drewsum/AC_Power_Meter/README.md

# AC_Power_Meter
ELEN3035 Final Project

AC Power Meter centered around an 8 bit PIC microcontroller

Built with KiCad 5.0.1 (with custom library), MPLAB X 5.05, and XC8 C compiler 1.45
