drewsum/AC_Power_Meter/hdw/AC_Power_Meter/AC_Power_Meter_bom.xlsx

References | Value | Quantity Per PCB | Digi-Key PN | Footprint | Dielectric | Voltage | Tolerance | Ampacity | Wattage | Config
C301 C504 C604 C607 C701 C704 C708 C803 C807 C808 C901 C902 C911 C917 C1004 C1005 C1006 C1009 C1012 C1013 C1014 C1101 C1103 C1201 C1403 C1405 C1501 | 0.1uF | 27 | 490-8020-1-ND | 0603 | X7R | 50V
C605 | 0.47uF | 1 | 490-3291-1-ND | 0603 | X7R | 25V
C302 C702 C705 C709 C804 C903 C904 C912 C918 C1202 C1404 | 10nF | 11 | 1276-1921-1-ND | 0603 | X7R | 50V
C1502 | 10nF | 1 | 445-2291-1-ND | 1206 | X7R | 630V
C608 C609 C907 C908 C914 C916 C920 | 10uF | 7 | 490-10517-1-ND | 0805 | X7R | 6.3V
C606 | 15pF | 1 | 478-10290-1-ND | 0603 | C0G/NP0 | 50V
C303 C703 C706 C710 C805 C905 C906 C913 C919 C1203 C1406 | 1nF | 11 | 478-1215-1-ND | 0603 | X7R | 50V
C909 C910 C915 C921 C1204 | 1uF | 5 | 490-1695-1-ND | 0805 | X7R | 10V
C1401 | 4.7nF | 1 | 399-9245-1-ND | 0805 | X7R | 200V
C601 C603 C1008 | 4.7uF | 3 | 478-10056-1-ND | 0805 | X7R | 25V
C1010 C1011 | 47pF | 2 | 478-1171-1-ND | 0603 | C0G/NP0 | 50V
C505 | 47uF | 1 | 478-3938-1-ND | 7343 |  | 16V | 10%
D901 | 1N4148WS | 1 | 1N4148WSFSCT-ND
D1401 D1402 D1403 D1404 D1405 | BAV21 | 5 | BAV21W-FDICT-ND
D1602 D1604 | Green | 2 | 160-1446-1-ND | 0603
D1601 D1605 | Red | 2 | 160-1447-1-ND | 0603
D1002 | Yellow | 1 | 160-1448-1-ND | 0603
F201 F401 | 15A | 2 | 283-4372-1-ND
F501 F502 | 3.15A | 2 | 283-4107-1-ND
HS1501 | Heatsink | 1
J501 | AUX_IN | 1
J203 | EARTH_IN | 1 | 36-8191-ND
J403 | EARTH_OUT | 1 | 36-8191-ND
J201 | HT_IN | 1 | 36-8191-ND
J401 | HT_OUT | 1 | 36-8191-ND
J202 | NEUT_IN | 1 | 36-8191-ND
J402 | NEUT_OUT | 1 | 36-8191-ND
J404 | Output Socket | 1 | Q337-ND
J801 | Prog | 1
J1001 | USB_B_Mini | 1 | 732-2109-1-ND
L601 | 3.3u | 1 | 541-2567-1-ND | IHLP1212 |  |  | 20% | 2.7A
L801 L802 L1001 L1002 | 600R 0.5A | 4 | 732-1593-1-ND
MK201 MK203 MK1303 MK1304 MK1307 MK1311 MK1312 MK1315 MK1316 | 4-40 Screw | 9 | 36-9502-ND 36-9900-ND
MK1305 MK1306 MK1309 MK1313 MK1314 MK1317 MK1318 | 4-40 Standoff | 7 | 36-8400-ND
MK1301 | Housing | 1
MK1302 | Lid | 1
MK202 MK204 | Nut | 2 | 36-4694-ND
P201 | AC In Socket | 1 | Q223-ND
PS501 | TMLM04112 | 1 | 1951-1352-ND
Q1401 Q1402 Q1403 Q1404 | 2N7002 | 4
Q1501 | BT139-600 | 1 | 1740-1050-ND
Q501 | DMP3099L-7 | 1 | DMP3099L-7DICT-ND
R701 R702 R1201 R1202 | 0 | 4 | P0.0GCT-ND | 0603 |  |  | 1% |  | 1/10W
R302 R806 | 0 | 0 |  | 0603 |  |  | 1% |  | 1/10W | None
R1405 R1406 R1407 R1408 | 10 | 4 | MCT0603-10.0-CFCT-ND | 0603 |  |  | 1% |  | 2018-01-10
R1401 | 100k | 1 | RHM100KICT-ND | 1206 |  |  | 5% |  | 1/2W
R1403 | 100k | 1 | P100KHCT-ND | 0603 |  |  | 1% |  | 1/10W
R301 R501 R508 R602 R603 R606 R703 R704 R705 R805 R901 R902 R904 R905 R906 R909 R910 R1004 R1101 R1102 R1103 R1104 R1203 R1204 R1404 R1501 R1502 R1601 R1602 R1606 R1609 | 10k | 31 | RHM10KADCT-ND | 0603 |  |  | 1% |  | 1/10W
R1505 | 180 | 1 | A115990CT-ND | 2512 |  |  | 1% |  | 1W
R608 R907 | 1M | 2 | A130109CT-ND | 0603 |  |  | 1% |  | 1/10W
R807 R908 R1009 R1402 R1603 R1604 R1608 R1611 | 1k | 8 | MCT0603-1.00K-CFCT-ND | 0603 |  |  | 1% |  | 1/10W
R1504 | 1k | 1 | 541-1.0KXCT-ND | 2512 |  |  | 5% |  | 1W
R1503 | 220 | 1 | 311-220HRCT-ND | 0603 |  |  | 1% |  | 1/10W
R1007 R1008 | 27 | 2 | P27.0HCT-ND | 0603 |  |  | 1% |  | 1/10W
R502 R903 | 3.3k | 2 | 311-3.30KHRCT-ND | 0603 |  |  | 1% |  | 1/10W
R1506 | 39 | 1 | 541-39XCT-ND | 2512 |  |  | 5% |  | 1W
R607 | 43.2k | 1 | P43.2KHCT-ND | 0603 |  |  | 1% |  | 1/10W
R609 | 576k | 1 | 311-576KHRCT-ND | 0603 |  |  | 1% |  | 1/10W
R605 | 80.6k | 1 | P80.6KHCT-ND | 0603 |  |  | 1% |  | 1/10W
SW801 | MRESET | 1
U1402 | 74LVC1G17 | 1 | 296-11934-1-ND
U1501 | 74LVC1G32 | 1 | 296-9848-1-ND
U301 | ACS722LLCTR-20AB | 1 | 620-1637-1-ND
U1502 | FOD4218 | 1 | FOD4218S-ND
U1002 | FT234XD | 1 | 768-1178-1-ND
U1101 | ISO7321C | 1 | 296-42102-1-ND
U602 | LT3973-DD | 1 | LT3973EDD#PBF-ND
U901 U902 U903 U904 | LTC6240IS5 | 4 | LTC6240IS5#TRMPBFCT-ND
U1401 | LTV-356T | 1 | 160-1337-1-ND
U701 | PIC18LF67K40-I/PT | 1 | PIC18LF67K40-I/PT-ND
U1201 | SSD1306 | 1
U1004 | TPD3S014DBVR | 1 | 296-38835-1-ND
X701 | ASV-16.000MHz | 1 | 535-10072-1-ND
Z501 | UDZSTE-175.1B | 1 | UDZSTE-175.1BCT-ND | SOD323 |  | 5.1V
