drewsum/AC_Power_Meter/(list of files, cad)

Other CAD files:
sfw/U701_Firmware/AC_Power_Meter.X/dist/default/production/AC_Power_Meter.X.production.obj
