drewsum/AC_Power_Meter/hdw/AC_Power_Meter/AC_Power_Meter.pdf

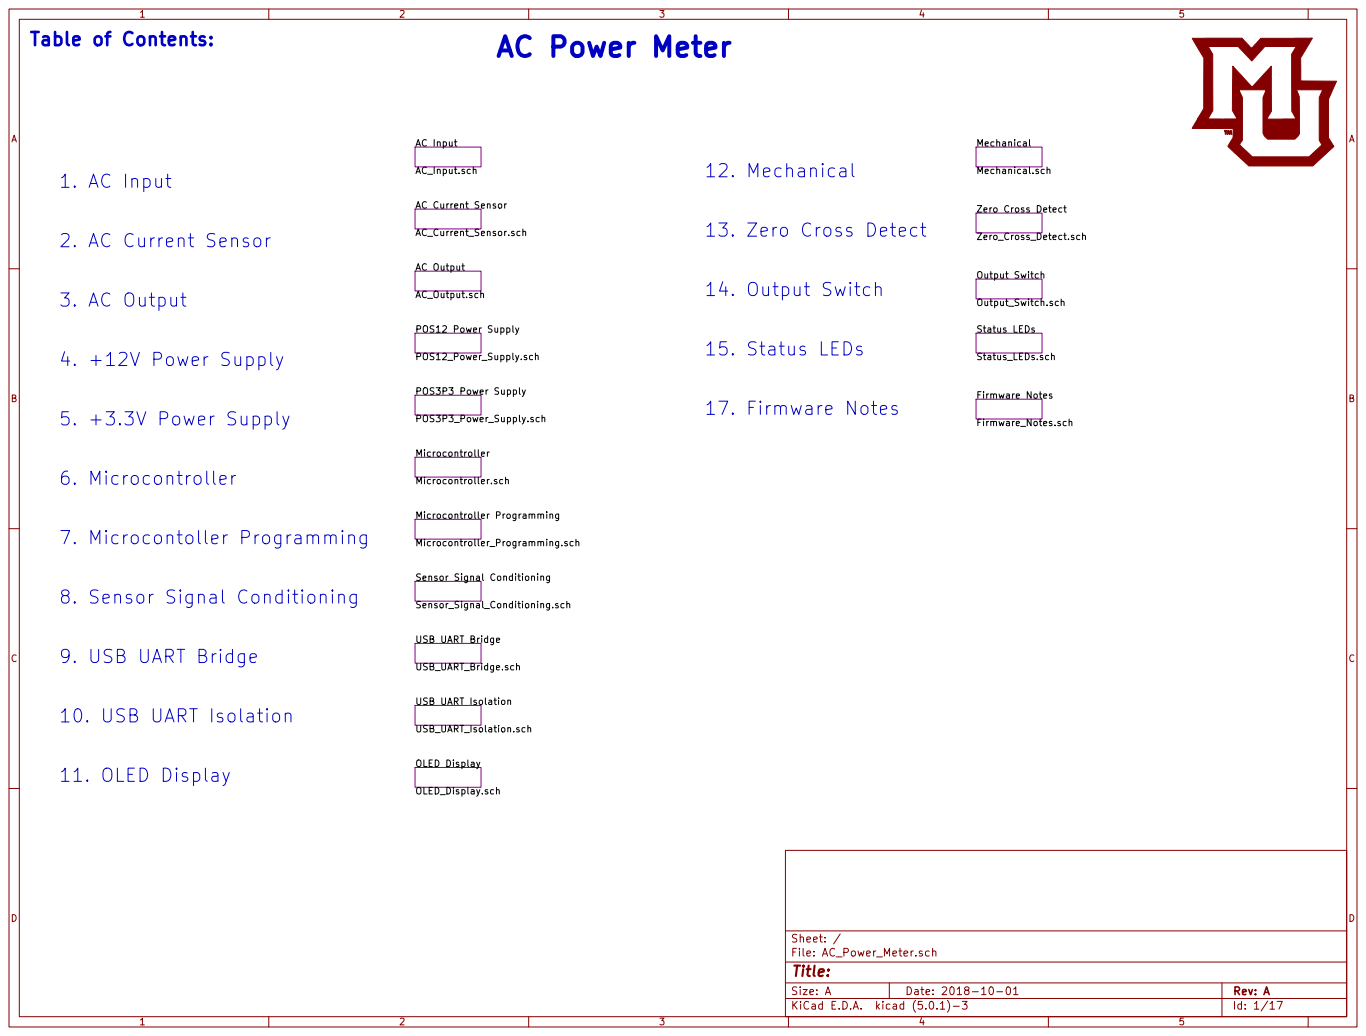
[picture p1: page 1]

AC_Input.sch AC Current Sensor AC_Current_Sensor.sch AC Output

Zero Cross Detect Zero_Cross_Detect.sch Output Switch

Output_Switch.sch Status LEDs Status_LEDs.sch Firmware Notes Firmware_Notes.sch

POS3P3_Power_Supply.sch Microcontroller Microcontroller.sch Microcontroller Programming

USB_UART_Bridge.sch USB UART Isolation USB_UART_Isolation.sch OLED Display

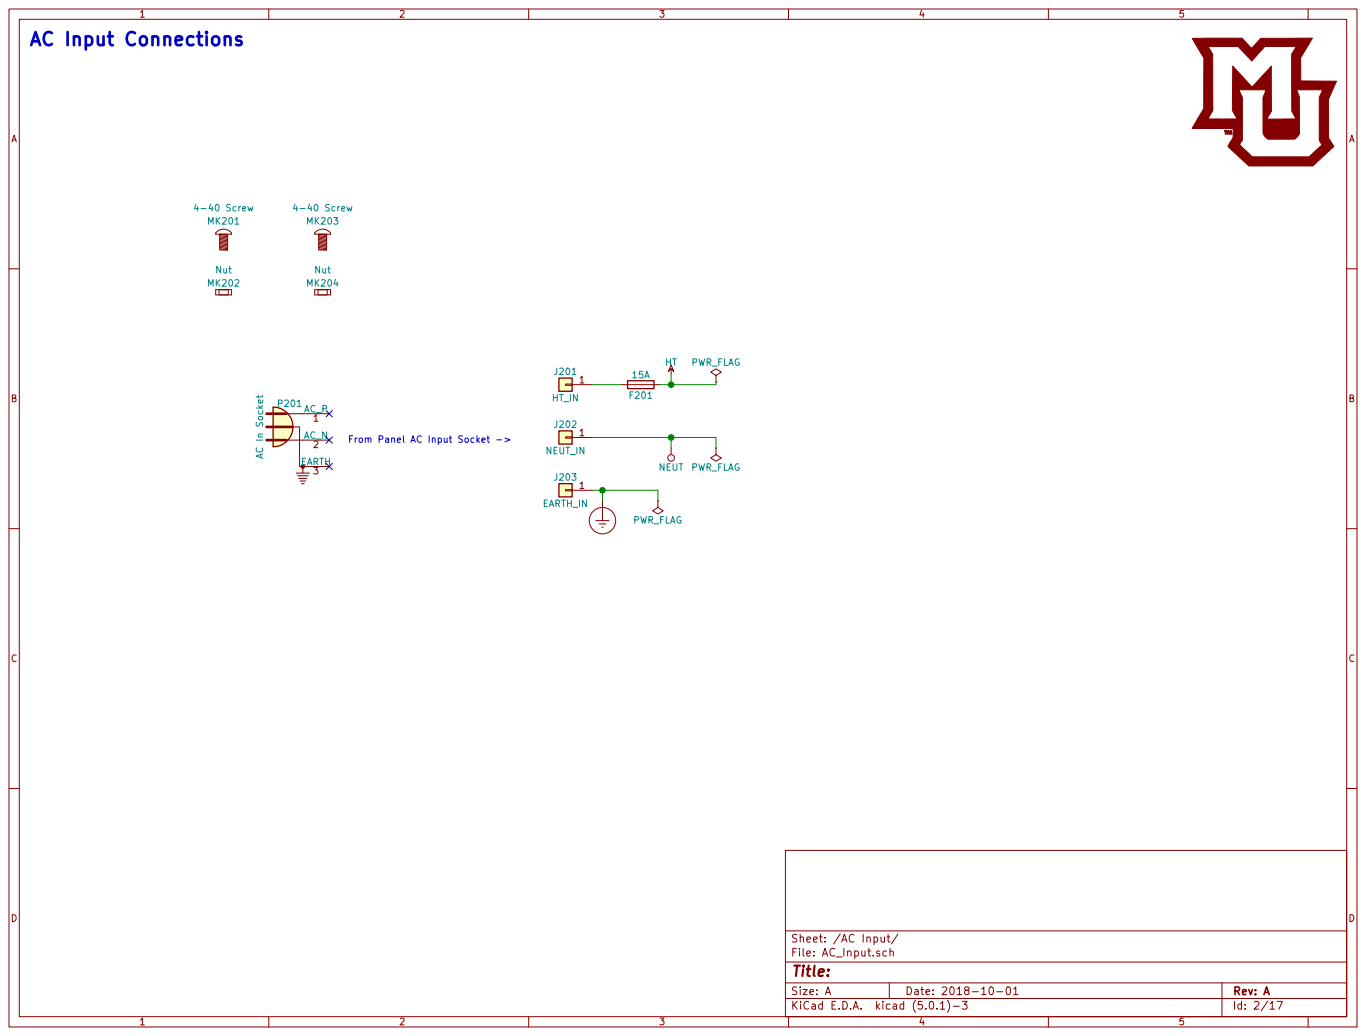
[picture p2: page 2]

From Panel AC Input Socket ->

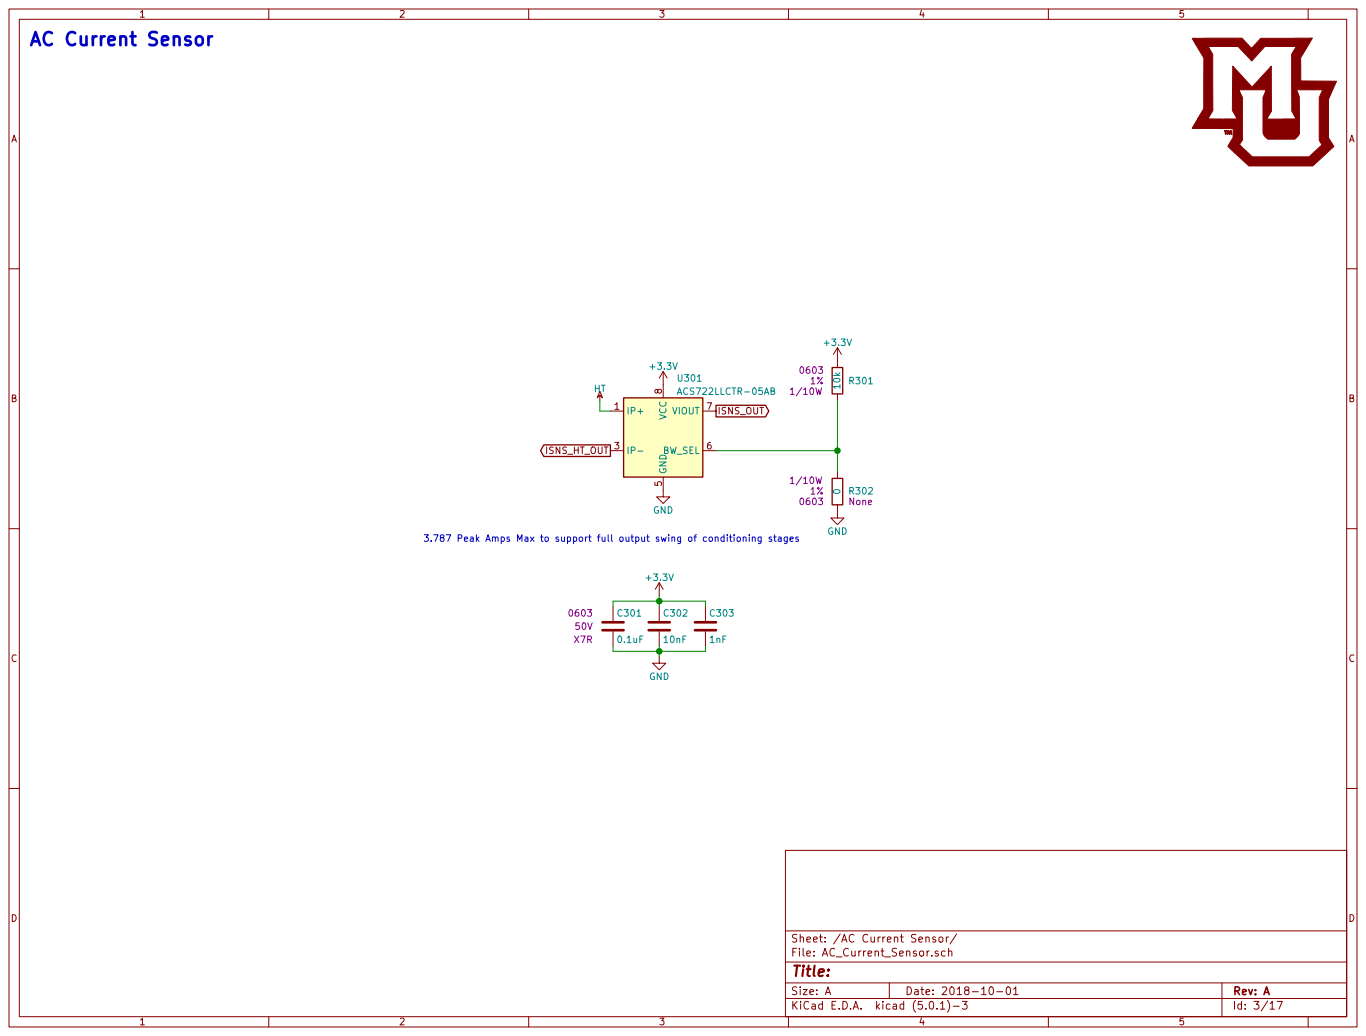
[picture p3: page 3]

3.787 Peak Amps Max to support full output swing of conditioning stages HT AC Current Sensor

File: AC_Current_Sensor.sch Sheet: /AC Current Sensor/ C301

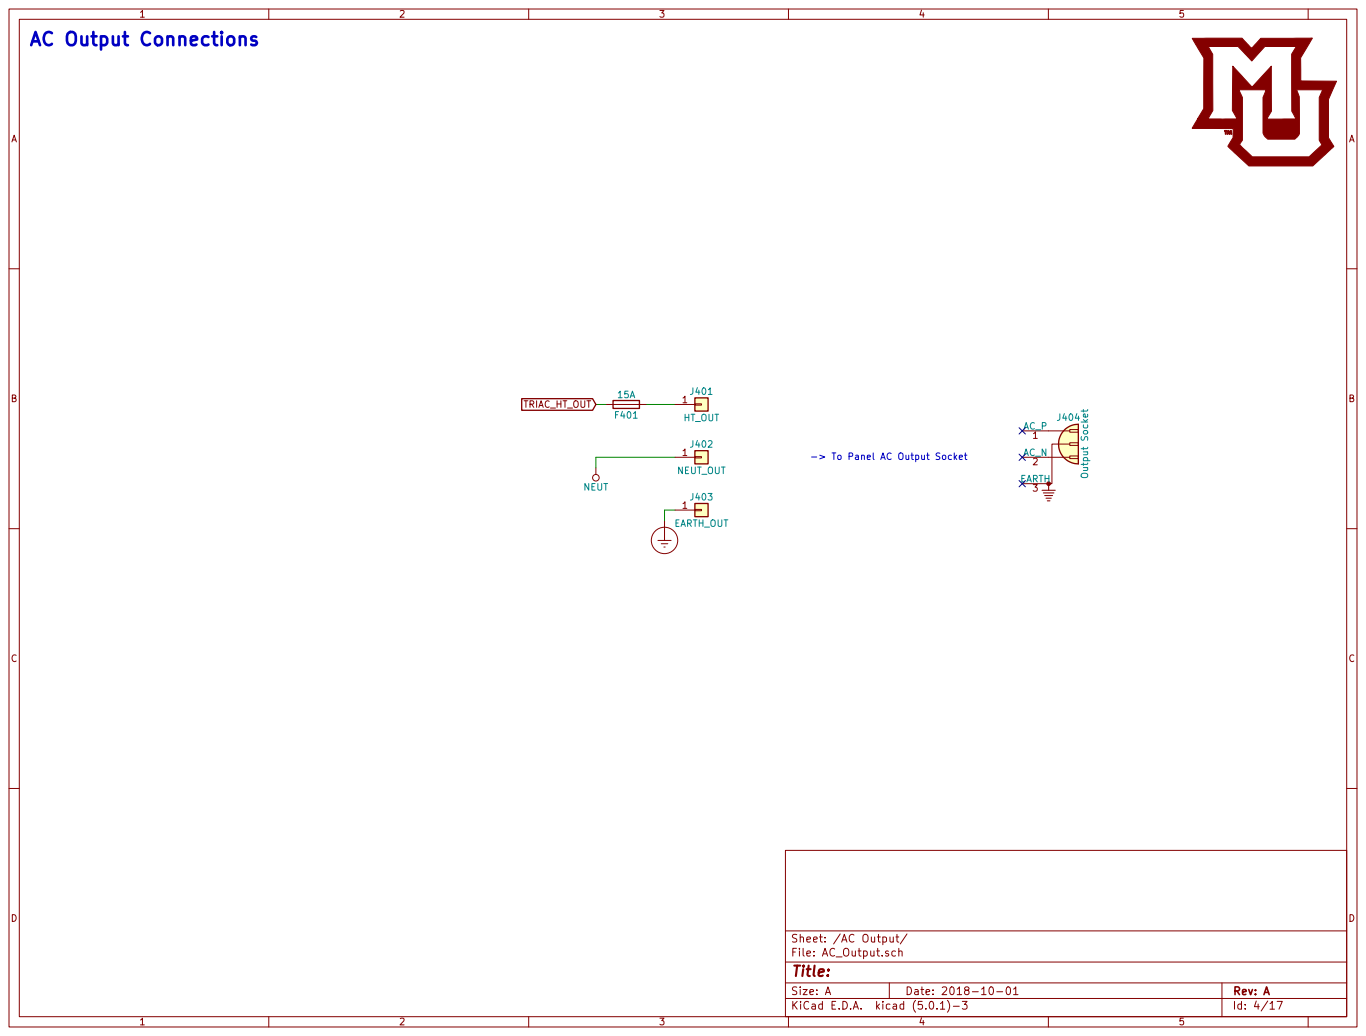
[picture p4: page 4]

-> To Panel AC Output Socket F401

Sheet: /AC Output/ NEUT

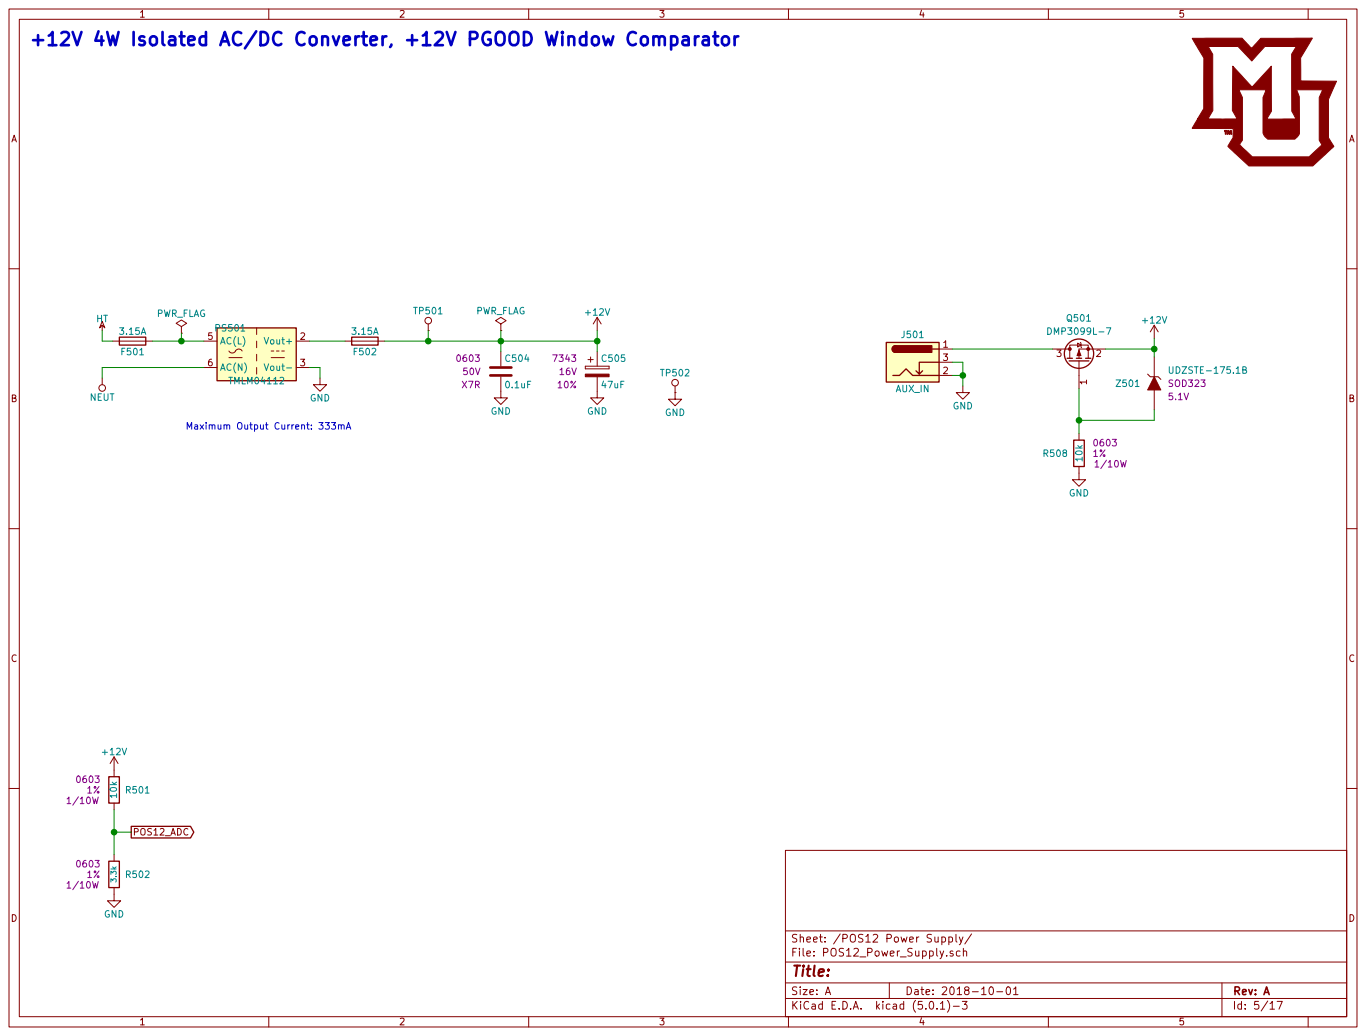
[picture p5: page 5]

+12V Maximum Output Current: 333mA HT NEUT

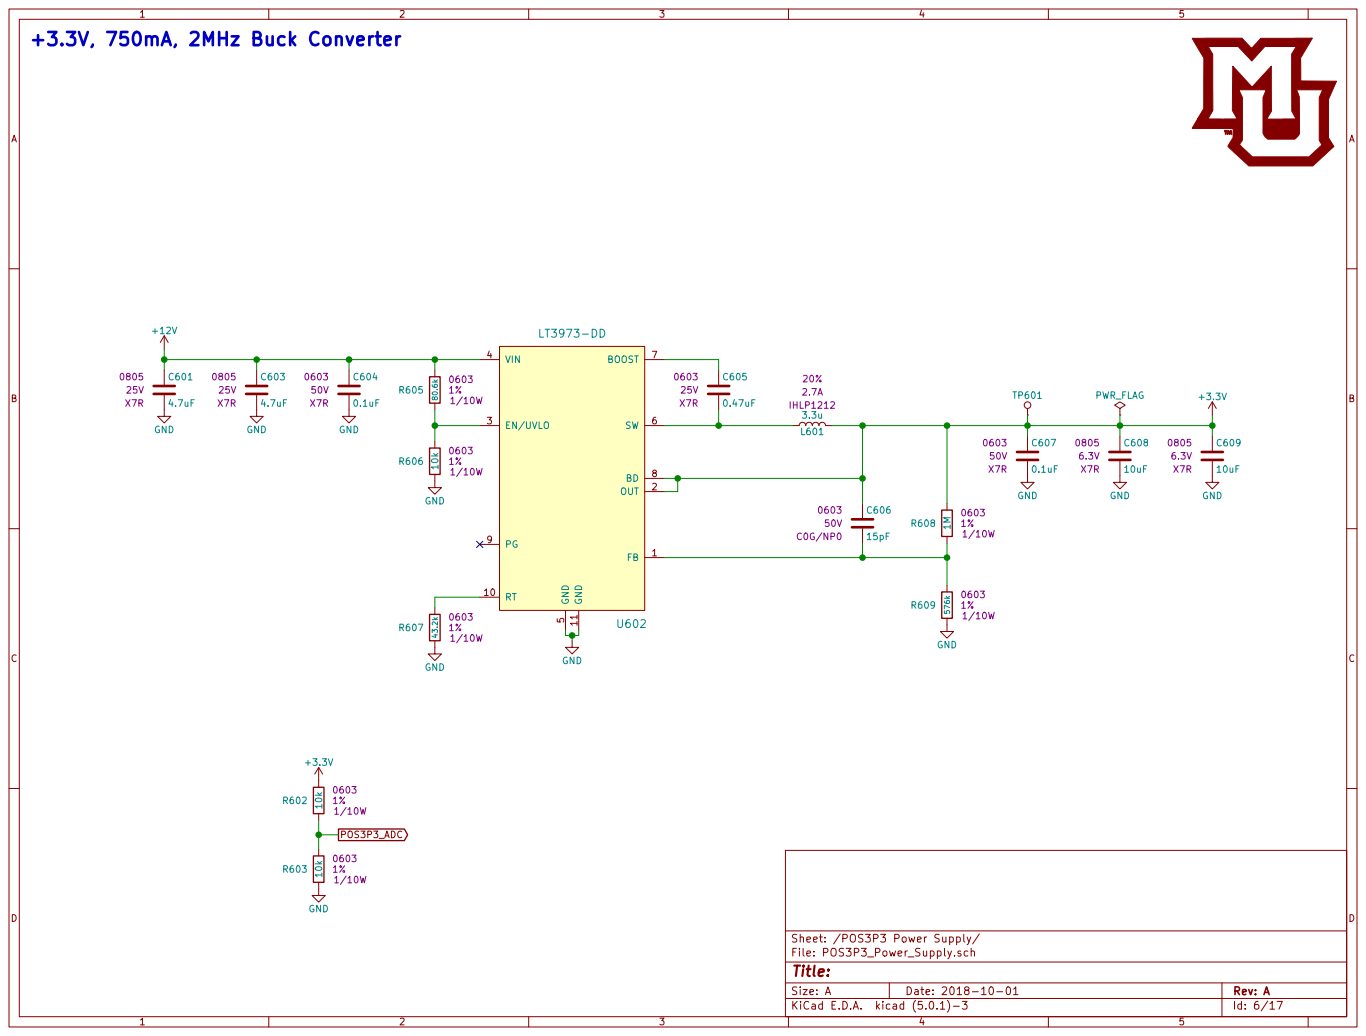
[picture p6: page 6]

5 SW 6 BOOST 7 BD 8 PG 9 U602

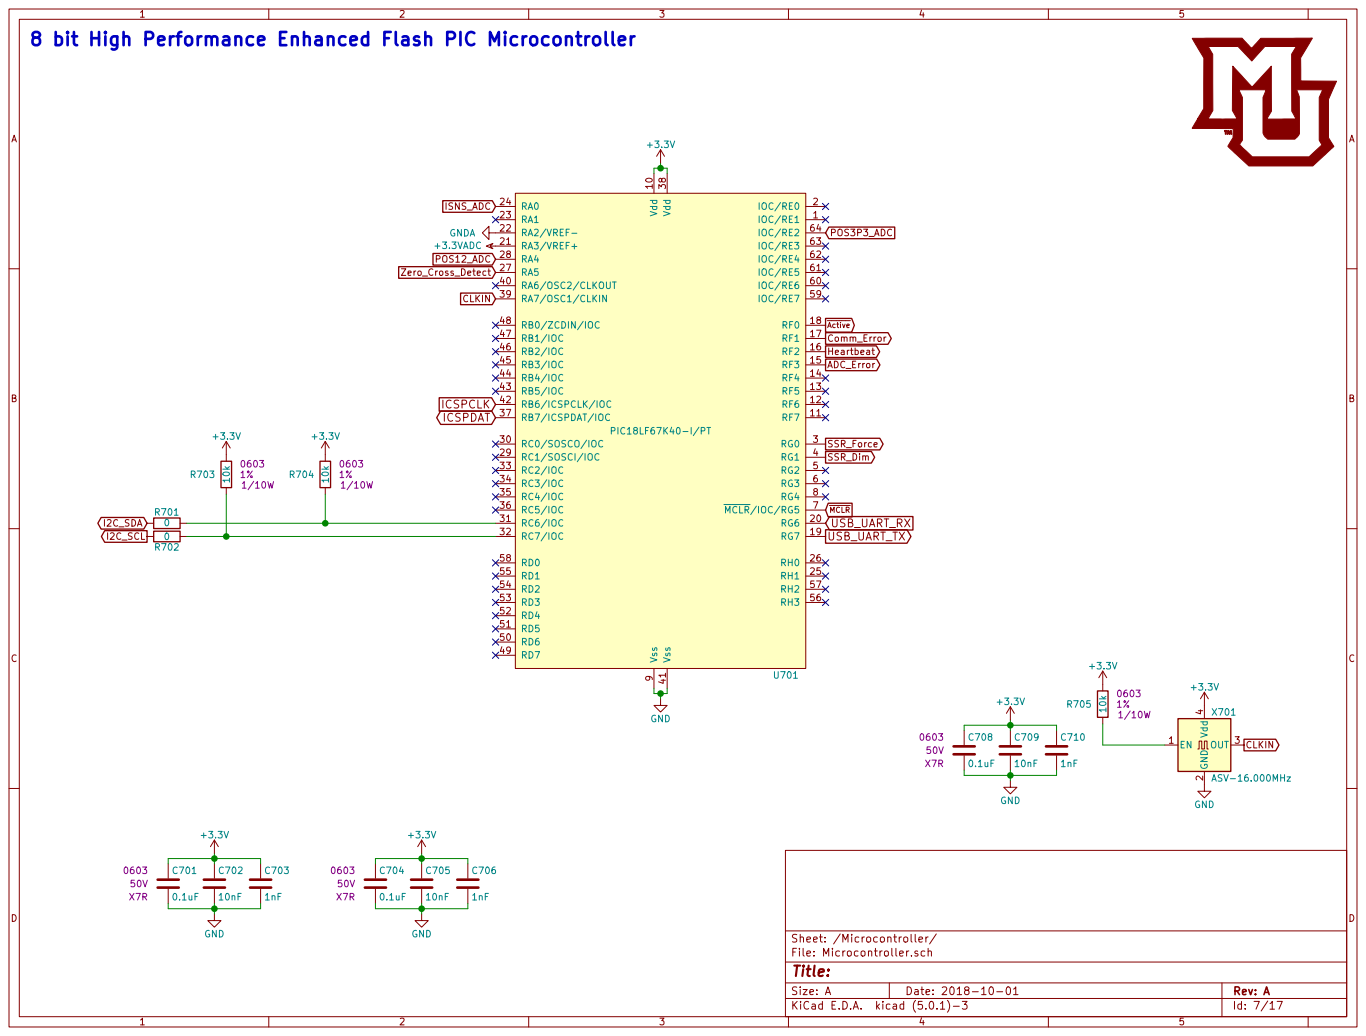
[picture p7: page 7]

8 bit High Performance Enhanced Flash PIC Microcontroller

Id: 7/17 Title: File: Microcontroller.sch Sheet: /Microcontroller/

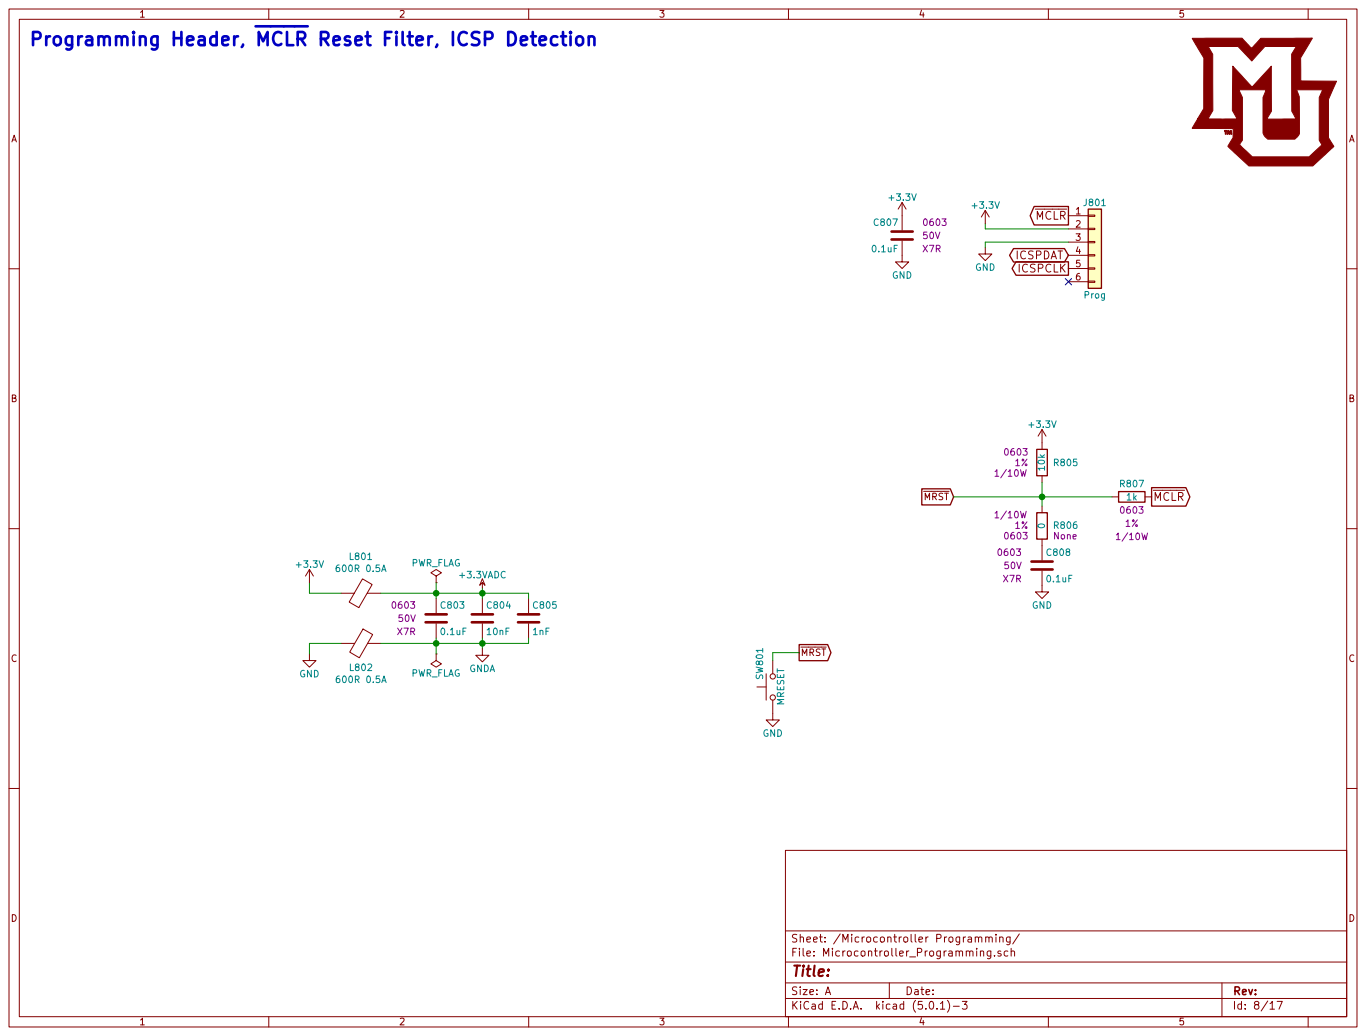
[picture p8: page 8]

ICSPDAT GND Programming Header, MCLR Reset Filter, ICSP Detection

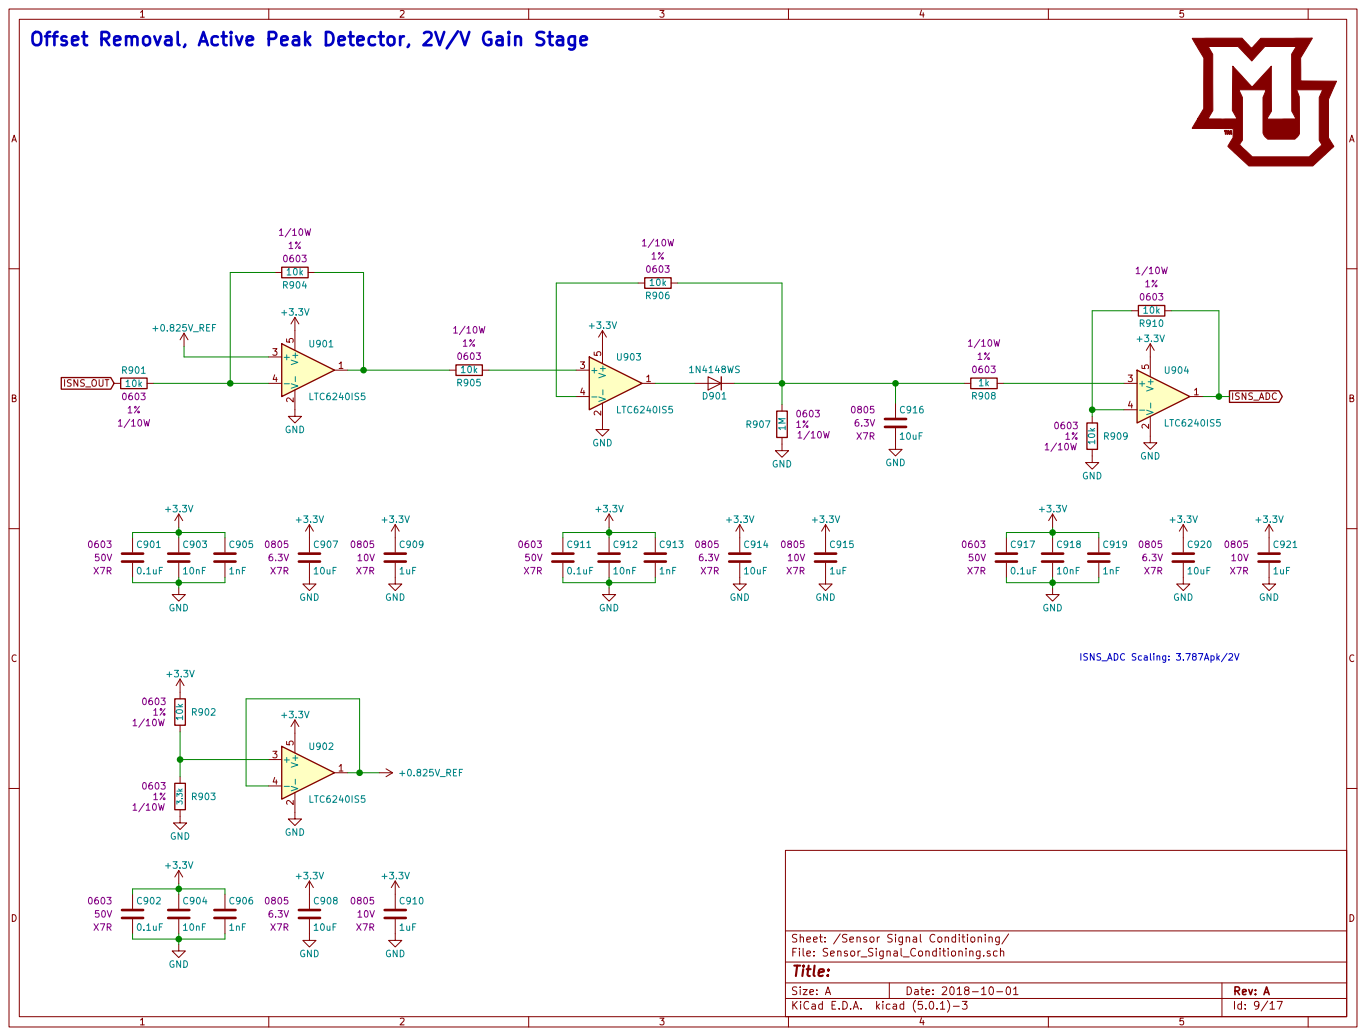
[picture p9: page 9]

1/10W Offset Removal, Active Peak Detector, 2V/V Gain Stage

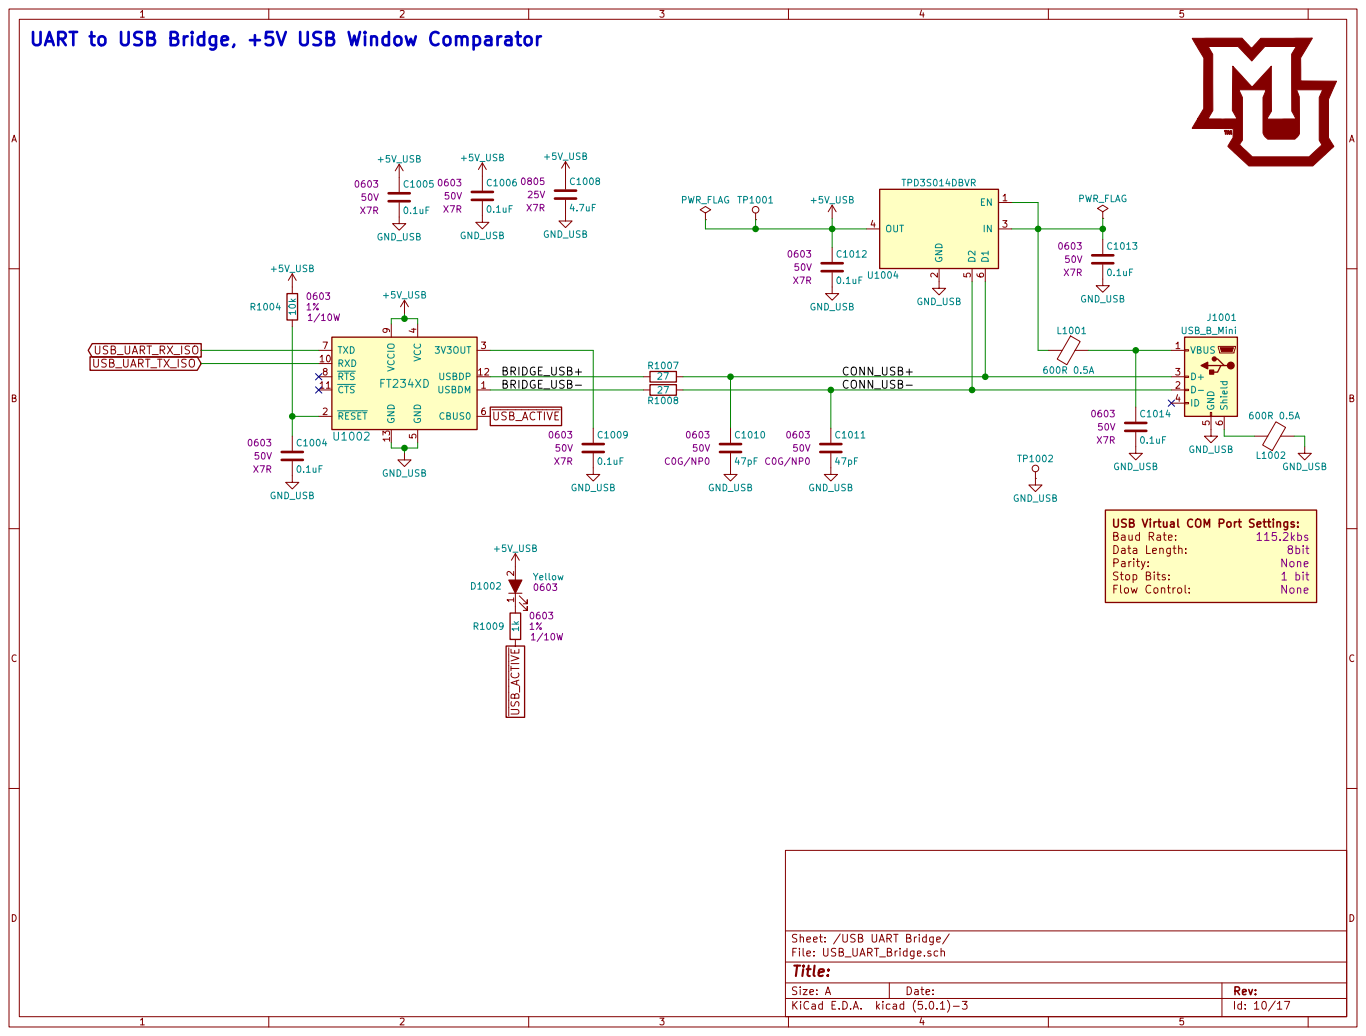
[picture p10: page 10]

USB Virtual COM Port Settings: 115.2kbs 8bit None

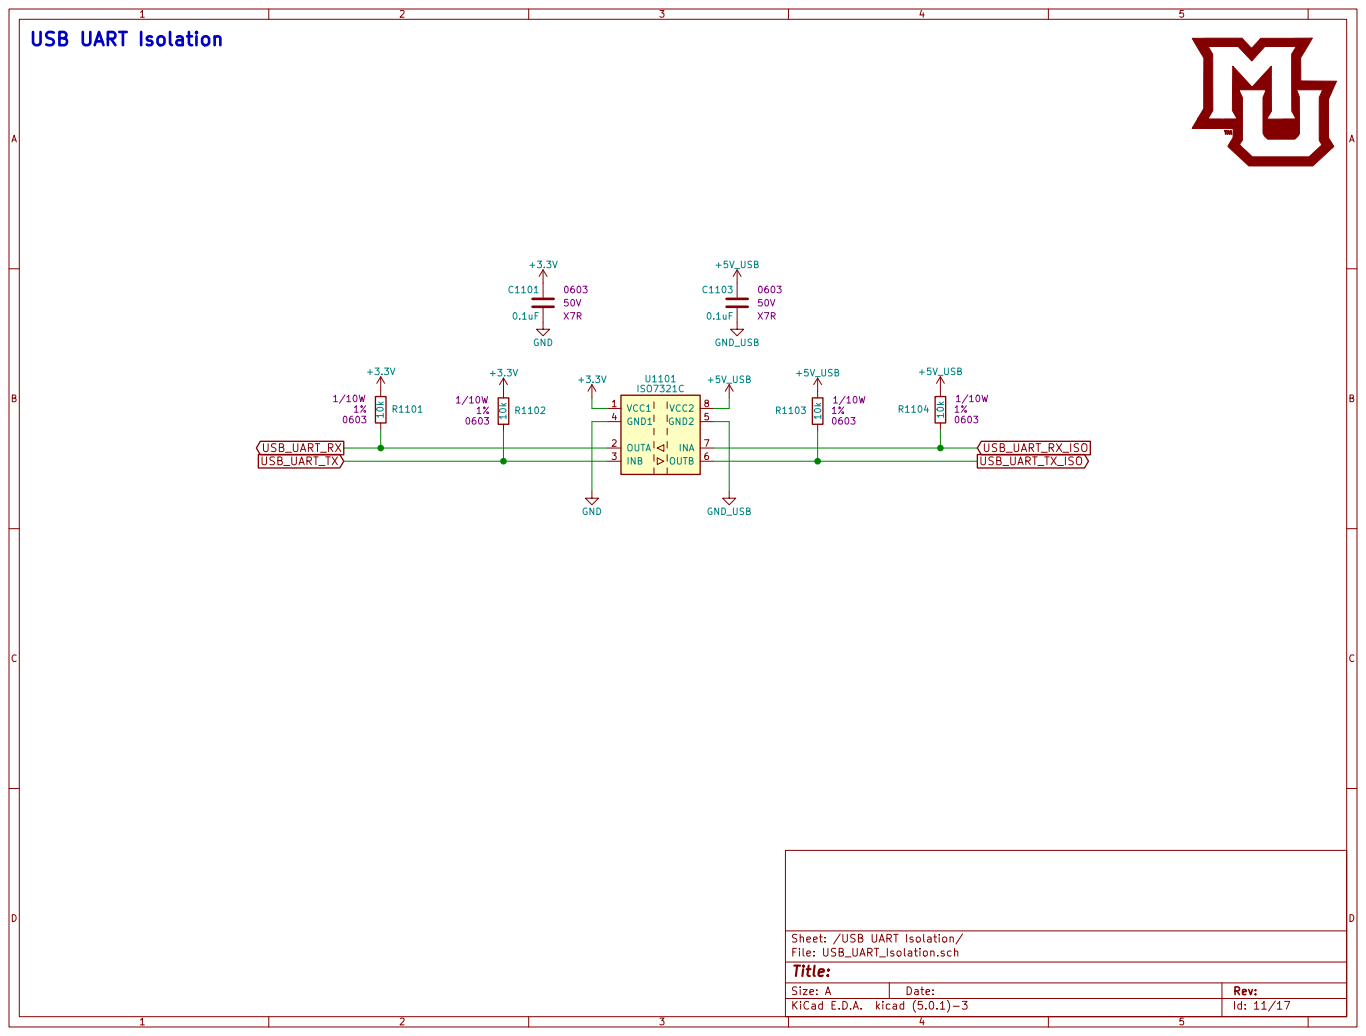
[picture p11: page 11]

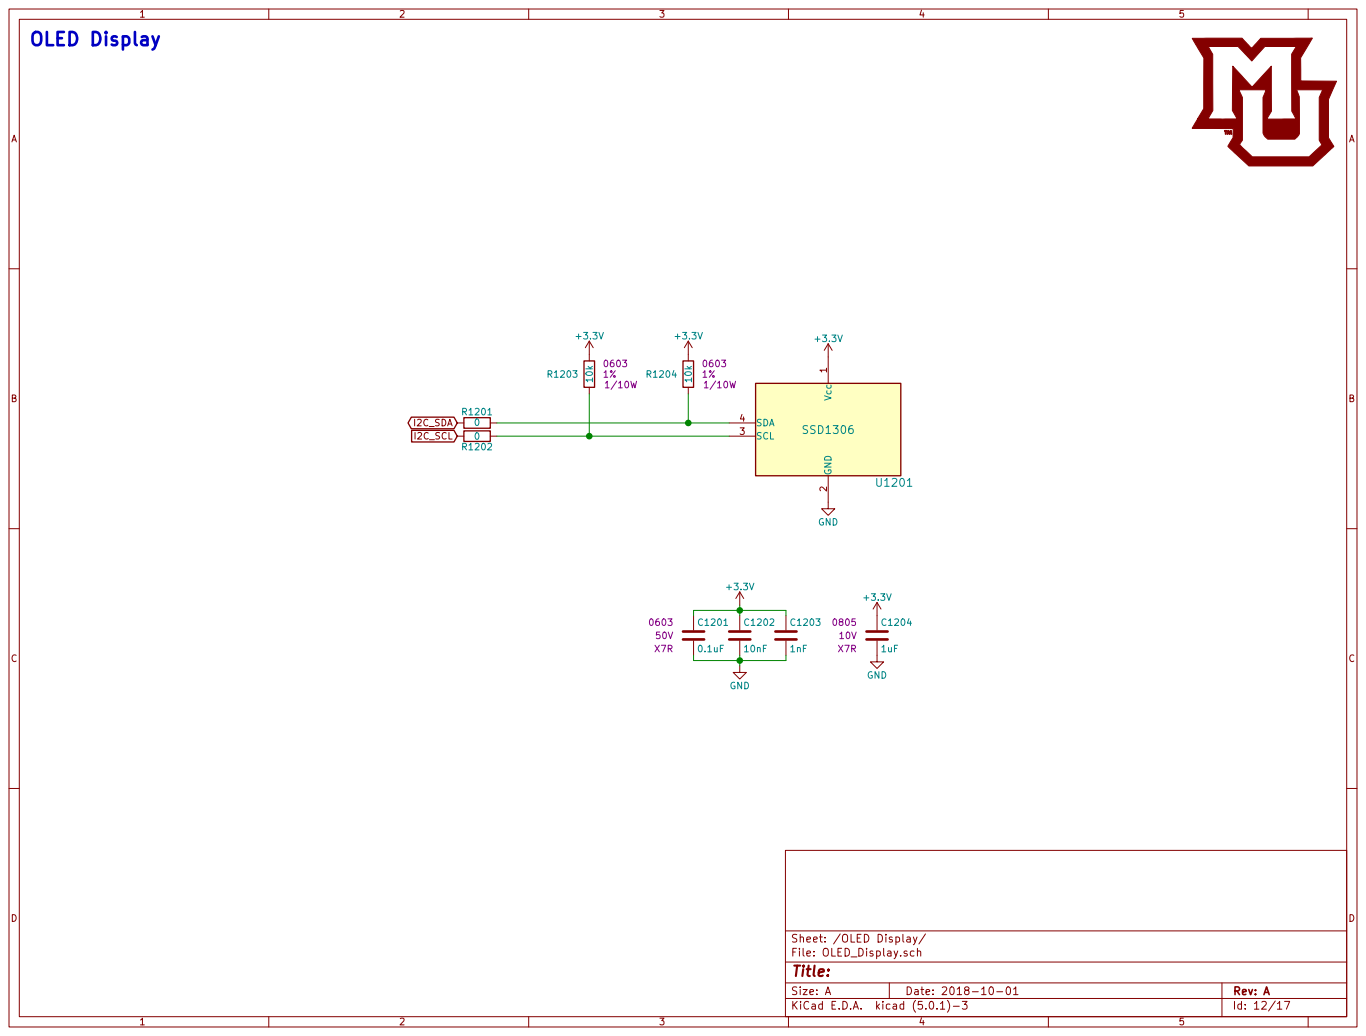
[picture p12: page 12]

Sheet: /OLED Display/ Vcc 1 GND

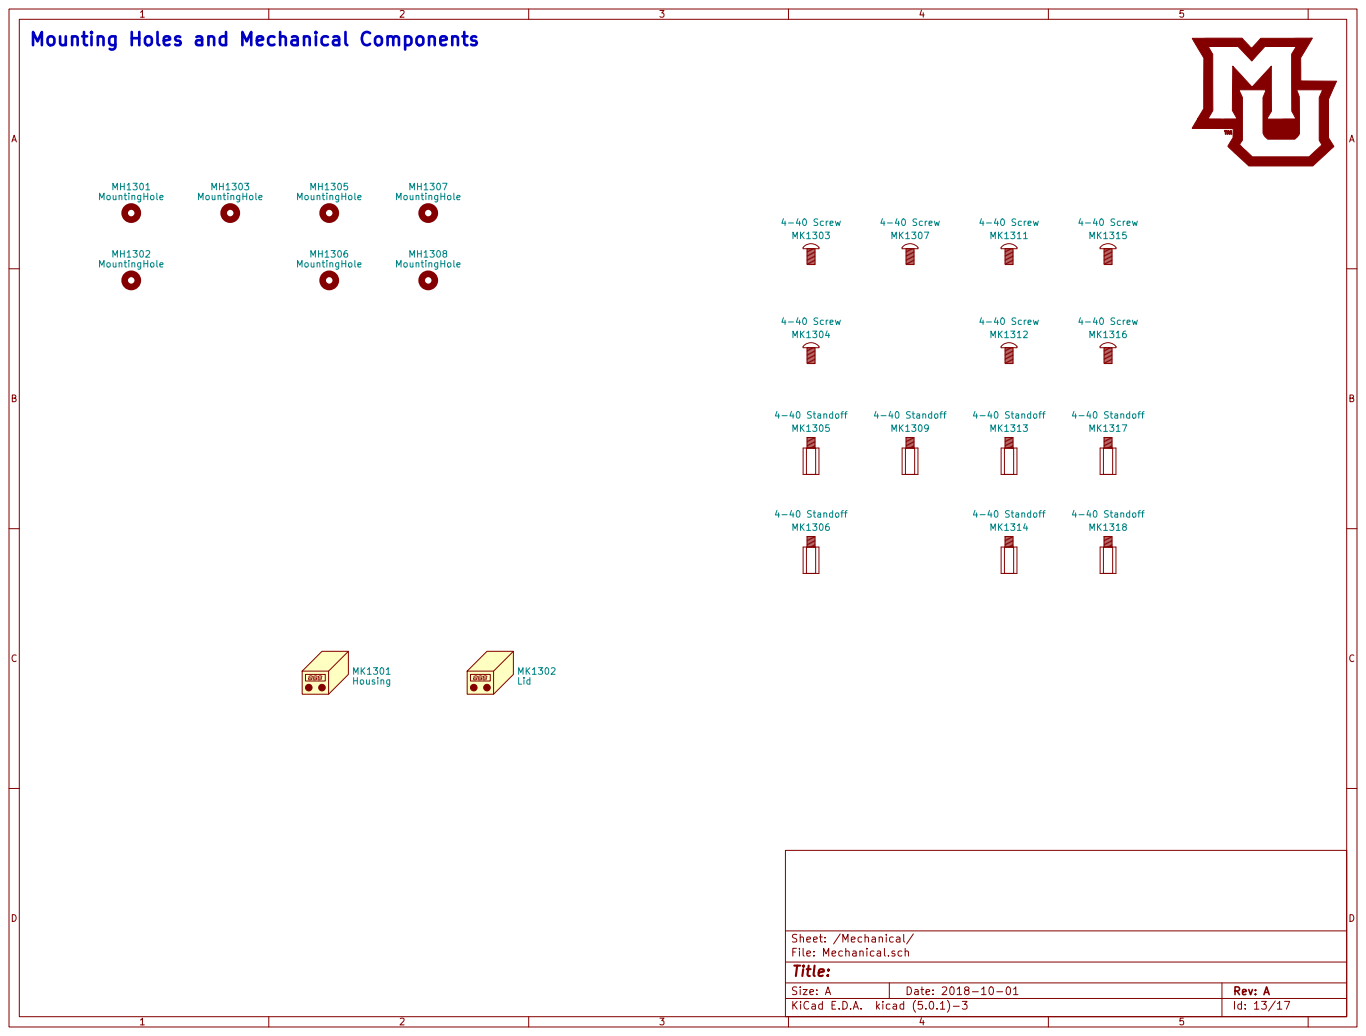
[picture p13: page 13]

Id: 13/17 Title: File: Mechanical.sch Sheet: /Mechanical/ Mounting Holes and Mechanical Components

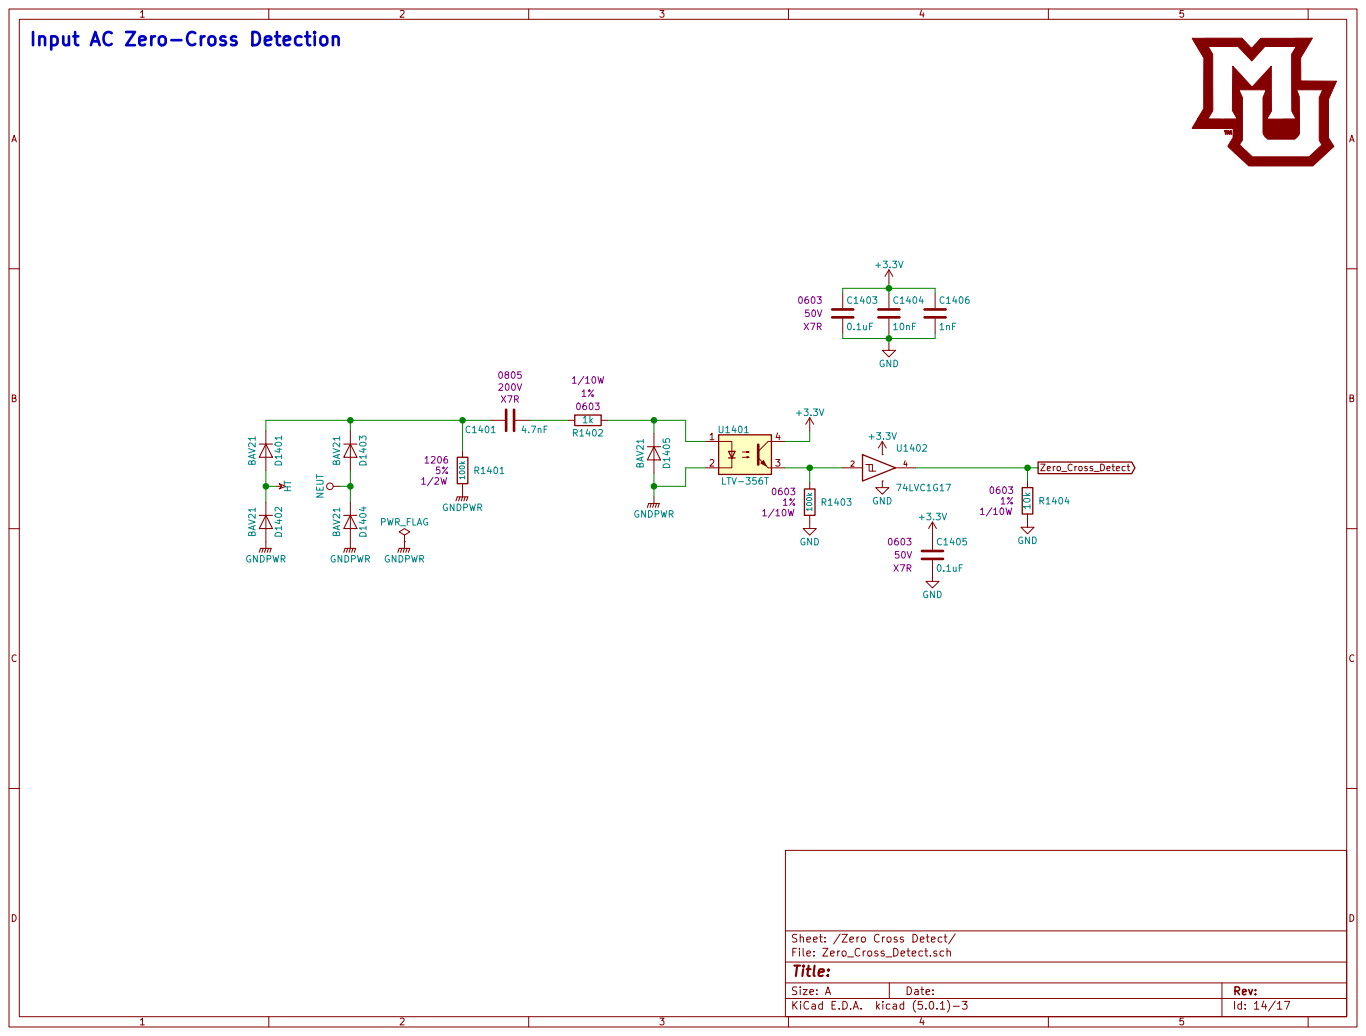
[picture p14: page 14]

Input AC Zero-Cross Detection

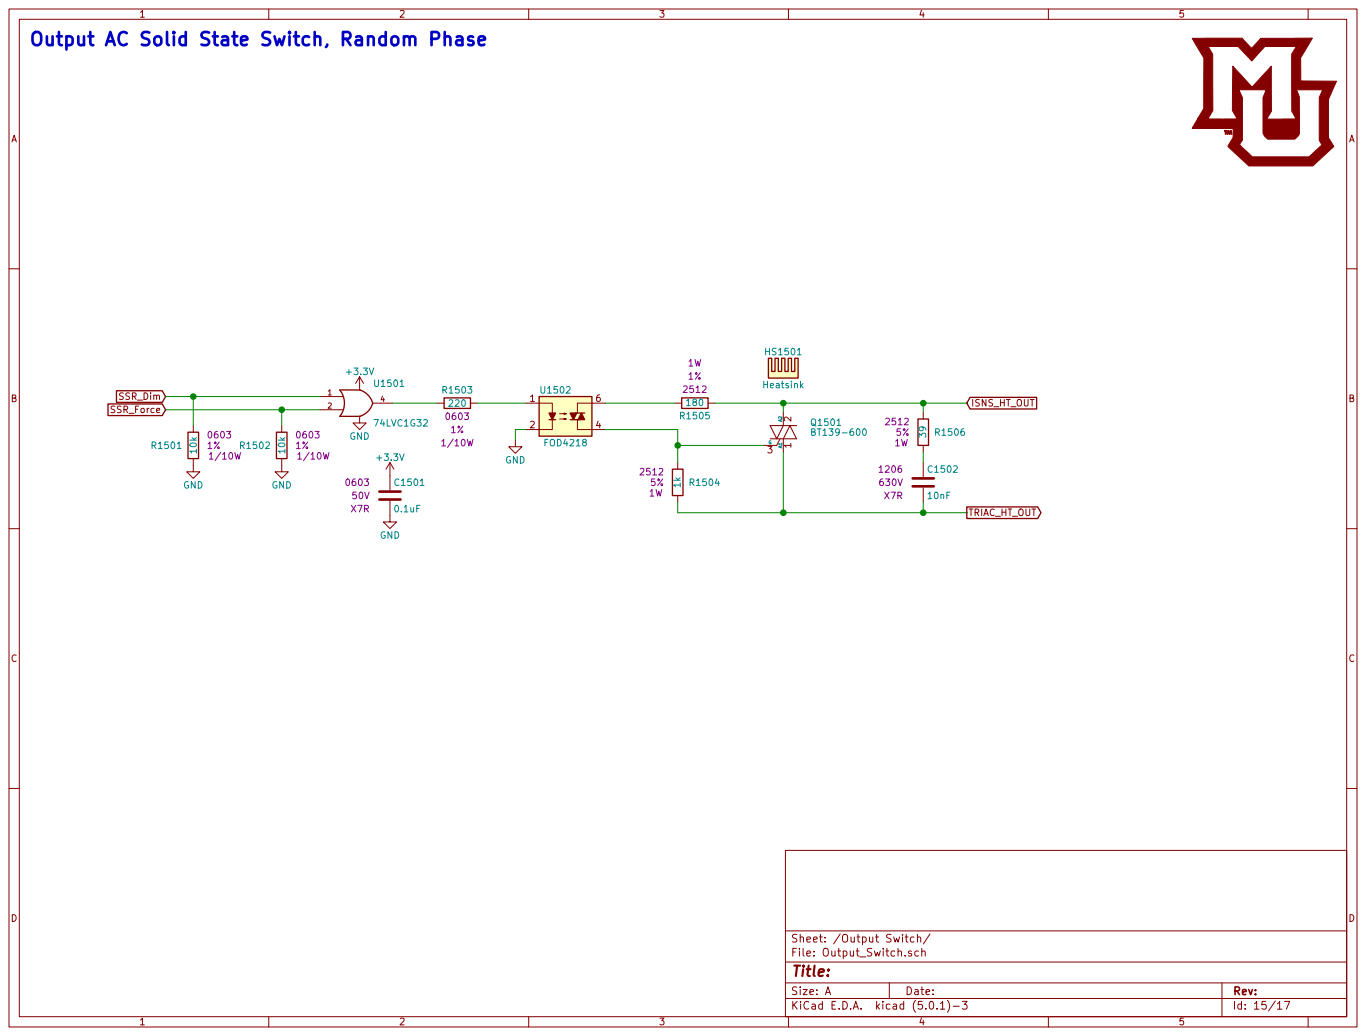
[picture p15: page 15]

TRIAC_HT_OUT Output AC Solid State Switch, Random Phase

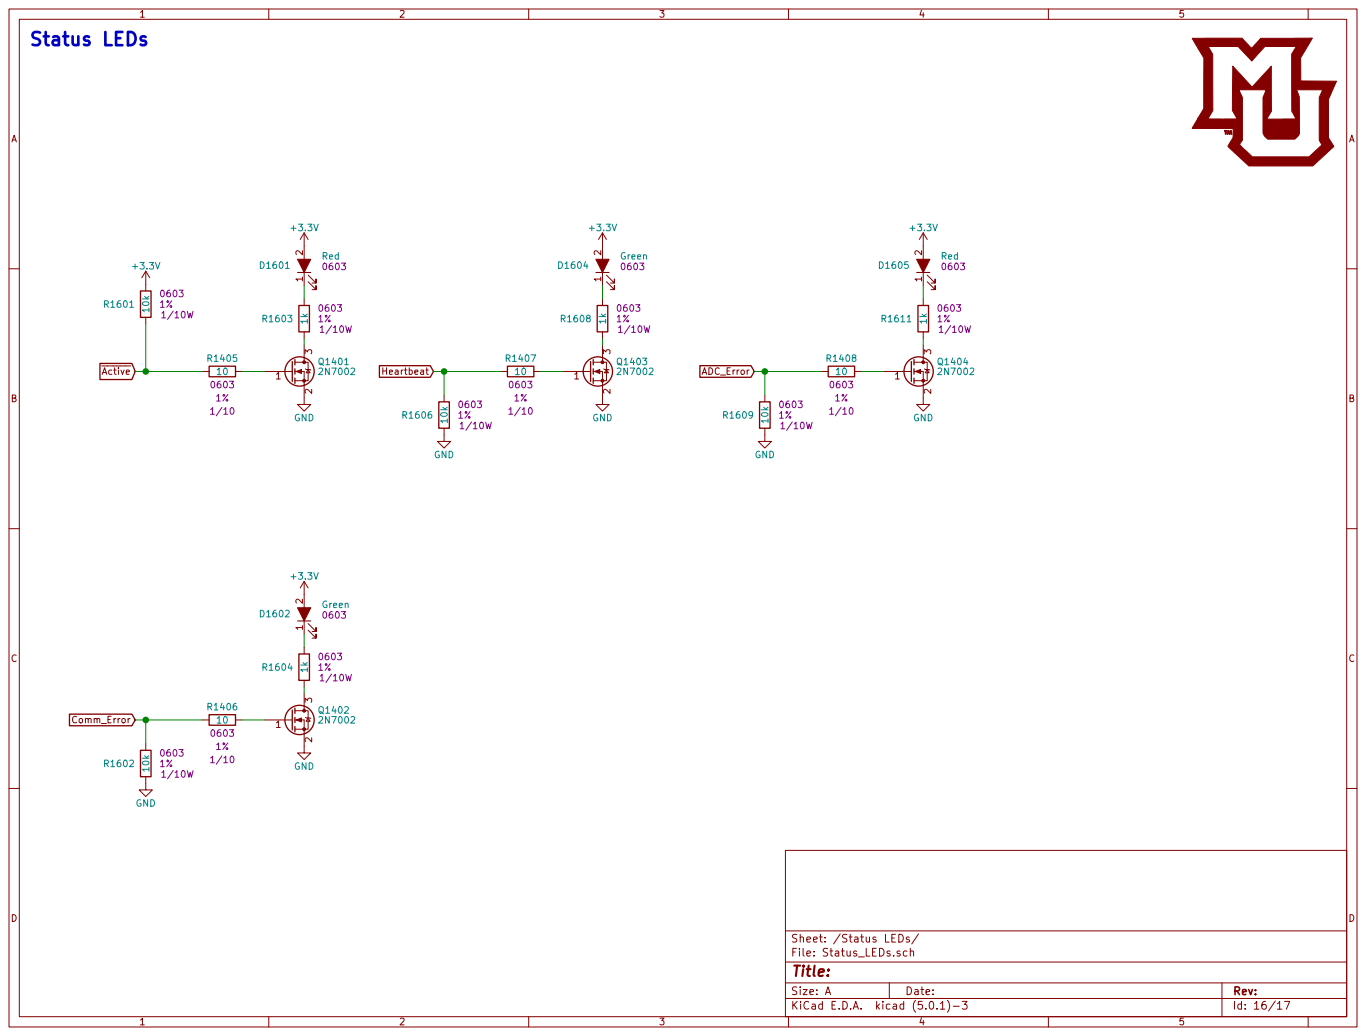
[picture p16: page 16]

File: Status_LEDs.sch Sheet: /Status LEDs/

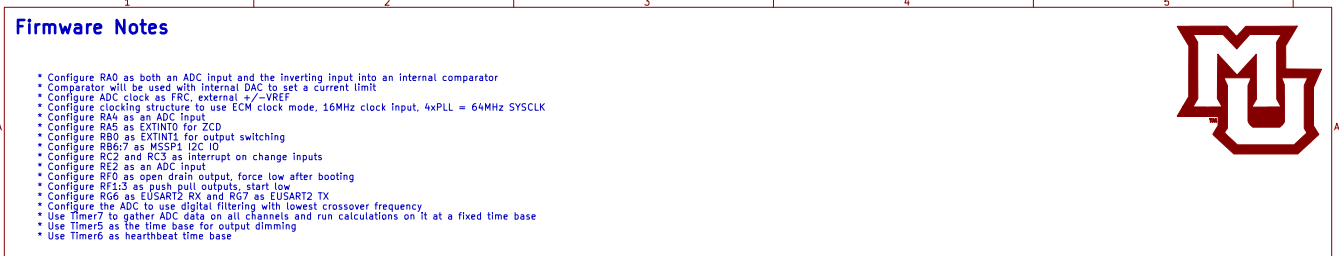
[picture p17: page 17]

* Configure RA0 as both an ADC input and the inverting input into an internal comparator
* Comparator will be used with internal DAC to set a current limit
* Configure ADC clock as FRC, external +/-VREF
* Configure clocking structure to use ECM clock mode, 16MHz clock input, 4xPLL = 64MHz SYSCLK
* Configure RA4 as an ADC input
* Configure RA5 as EXTINT0 for ZCD
* Configure RB0 as EXTINT1 for output switching
* Configure RB6:7 as MSSP1 I2C IO
* Configure RC2 and RC3 as interrupt on change inputs
* Configure RE2 as an ADC input
* Configure RF0 as open drain output, force low after booting
* Configure RF1:3 as push pull outputs, start low
* Configure RG6 as EUSART2 RX and RG7 as EUSART2 TX
* Configure the ADC to use digital filtering with lowest crossover frequency
* Use Timer7 to gather ADC data on all channels and run calculations on it at a fixed time base
* Use Timer5 as the time base for output dimming
* Use Timer6 as hearthbeat time base

File: Firmware_Notes.sch Sheet: /Firmware Notes/
