drewsum/AC_Power_Meter/hdw/Design_Files/LTSpice/POS3P3_Power_Supply.asc

C1: cap; 20µ; Rser=1m Lser=1n
C2: cap; 15p
C3: cap; .47µ
L1: ind; 3.3µ; Rser=0.09
R1: res; 1Meg
R2: res; 576k
R3: res; 43.2k
R4: res; 100K
R5: res; 80.6k
R6: res; 10k
Rload: res; 5
U1: LT3973
V1: voltage; 12
Named nets: 0, IN, OUT
.tran 750u startup
