drewsum/AC_Power_Meter/hdw/Design_Files/LTSpice/Signal_Conditioning.asc

C1: cap; 10µ
D2: diode; 1N4148
R1: res; 10k
R2: res; 1Meg
R3: res; 1k
R4: res; 10k
R5: res; 10k
R6: res; 10k
R7: res; 10k
R10: res; 10k
R11: res; 10k
R12: res; 3.3k
U1: LTC6240
U2: LTC6240
U3: LTC6240
U4: LTC6240
V1: signal; SINE(1.65 0.1 60)
V2: voltage; 3.3
Named nets: 0, POS3P3, VREF, ISNS_ADC, ISNS_OUT
.tran 1 uic
