drewsum/AC_Power_Meter/hdw/Design_Files/LTSpice/ZCD.asc

C1: cap; 4.7n
D1: diode; BAS21HM
D2: diode; BAS21HM
D3: diode; BAS21HM
D4: diode; BAS21HM
D5: diode; BAS21HM
R1: res; 100k
R2: res; 100k
R3: res; 1k
U1: PC817A
V1: voltage; 3.3
V2: signal; SINE(0 170 60)
Named nets: 0, POS3P3, VOUT
.tran 0.05
