drewsum/AC_Power_Meter/hdw/AC_Power_Meter/AC_Power_Meter.kicad_pcb

## KiCad design hdw/AC_Power_Meter/AC_Power_Meter.kicad_pcb (2018-11-29)

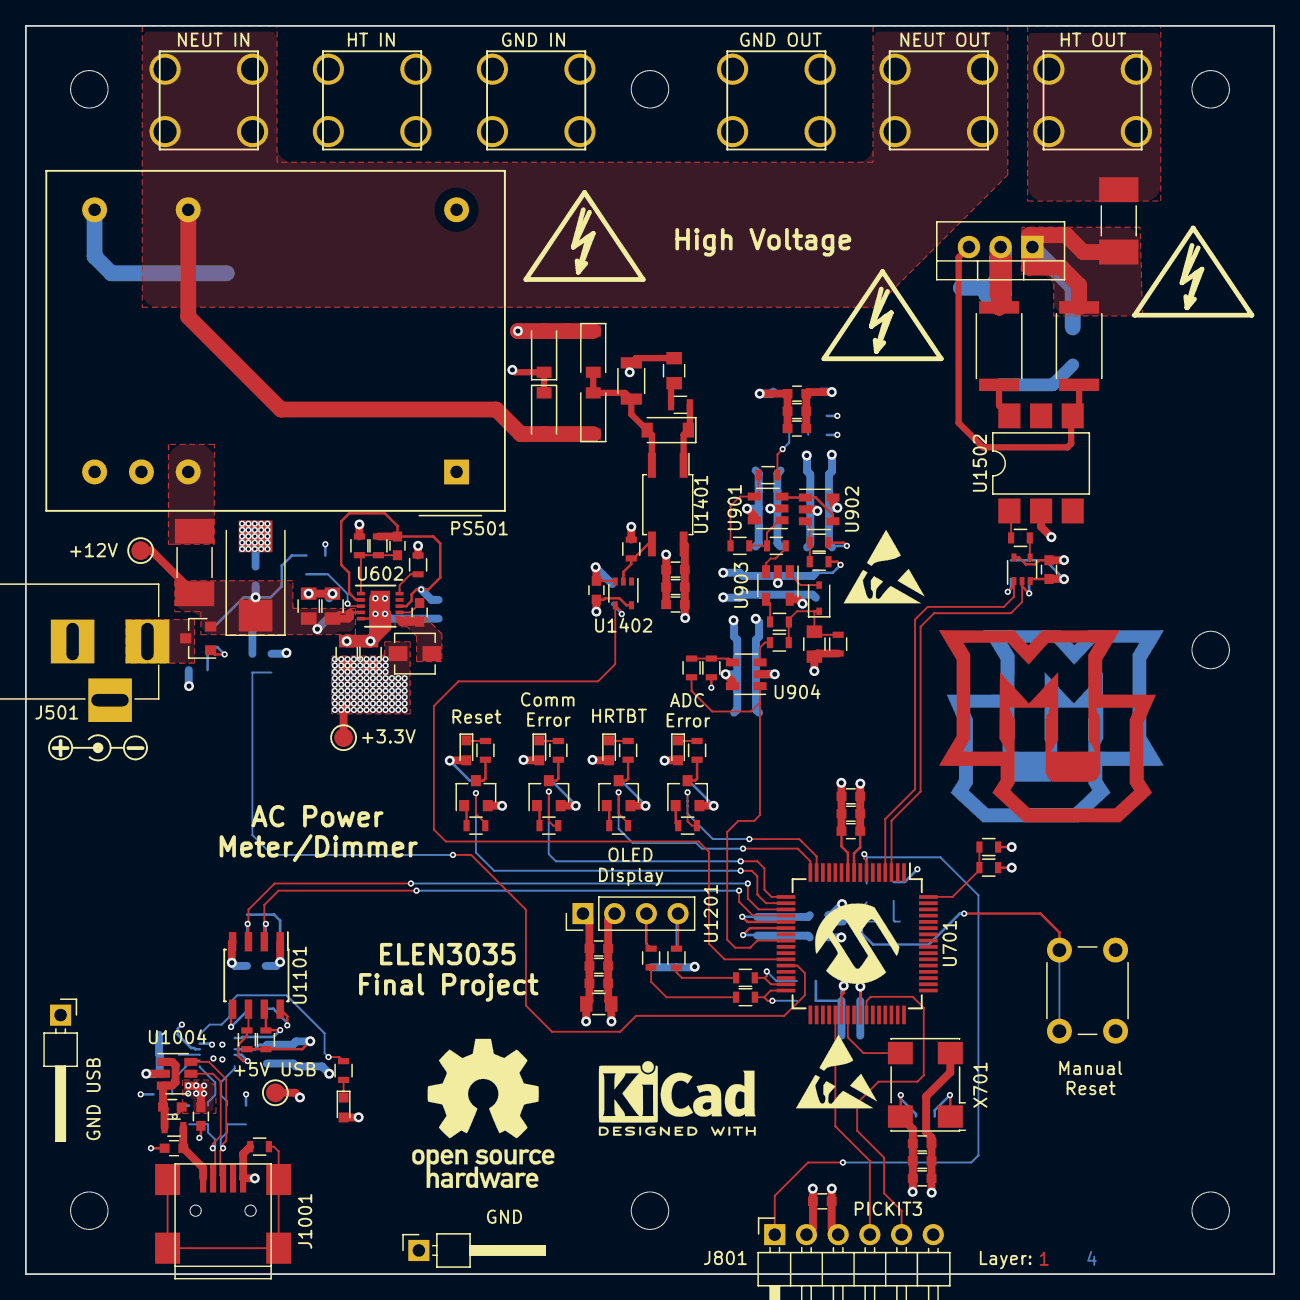
[picture p18: board AC_Power_Meter.kicad_pcb from above]

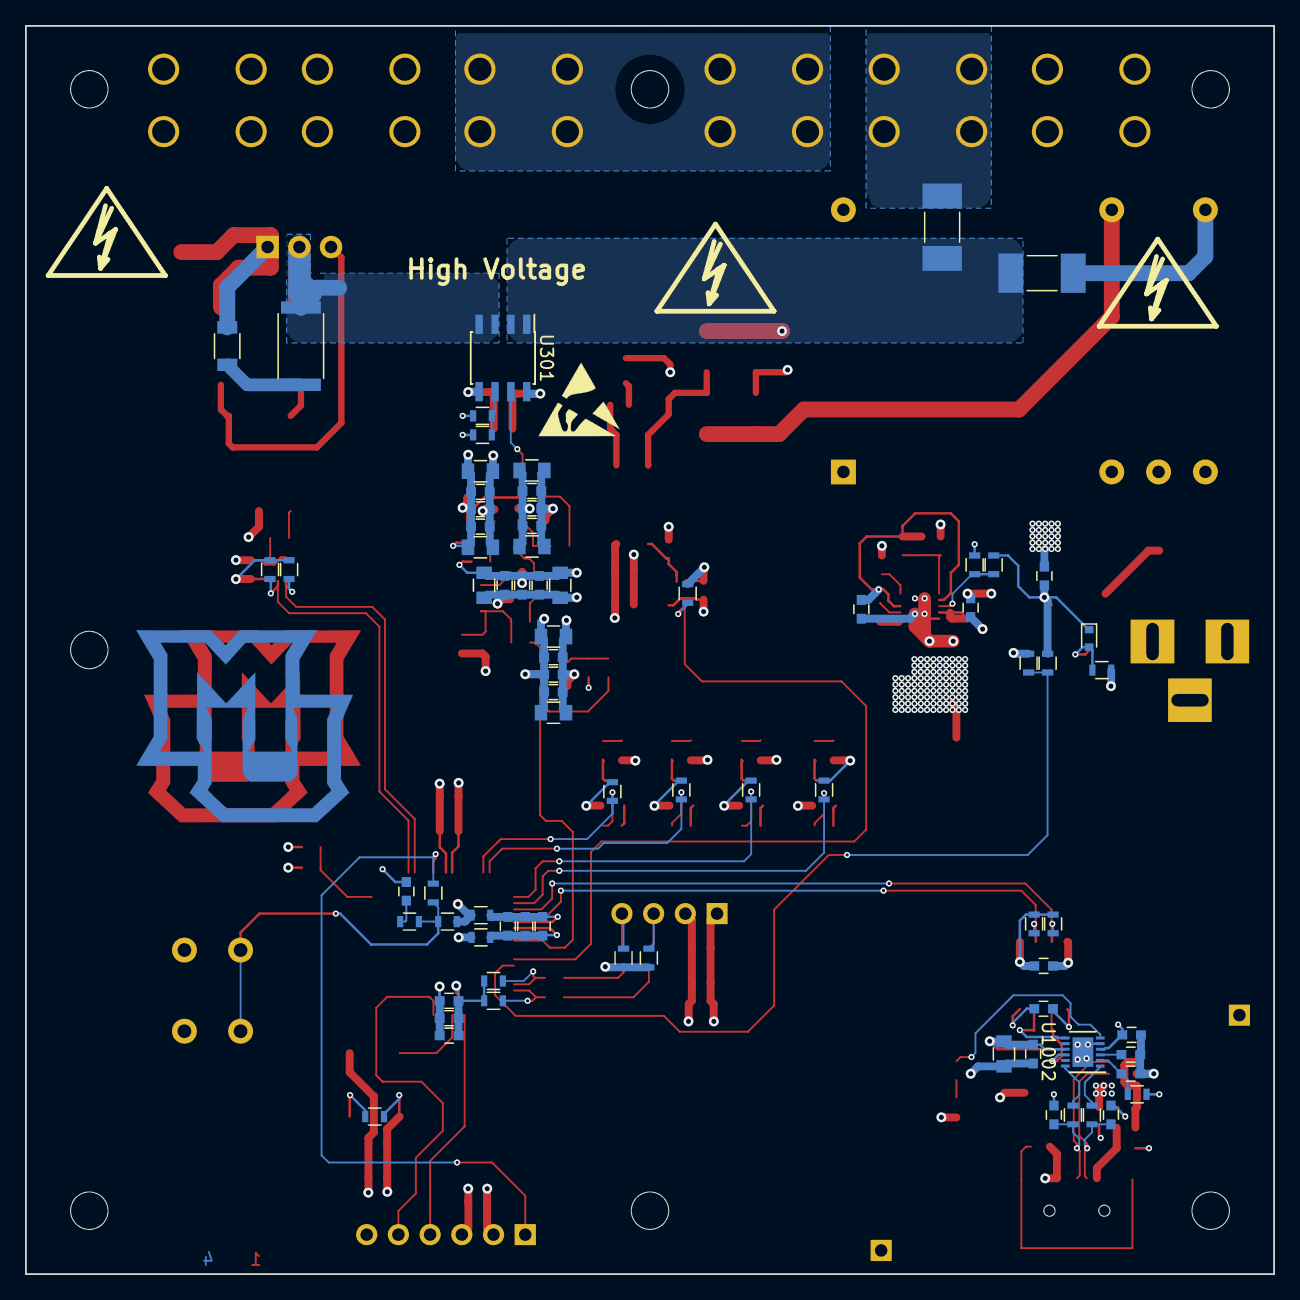
[picture p19: board AC_Power_Meter.kicad_pcb from below]

Board: 4 copper layers, 100.0 x 100.0 mm, 201 parts (75 on the bottom side), 95 nets.

Parts:
C301, C504, C604, C607, C701, C704, C708, C803, C807, C808, C901, C902, C911, C917, C1004, C1005, C1006, C1009, C1012, C1013, C1014, C1101, C1103, C1201, C1403, C1405, C1501: 0.1uF; C_0603
C302, C702, C705, C709, C804, C903, C904, C912, C918, C1202, C1404: 10nF; C_0603
C303, C703, C706, C710, C805, C905, C906, C913, C919, C1203, C1406: 1nF; C_0603
C505: 47uF; CP_Tantalum_Case-X_EIA-7343-43_Reflow
C601, C603, C1008: 4.7uF; C_0805
C605: 0.47uF; C_0603
C606: 15pF; C_0603
C608, C609, C907, C908, C914, C916, C920: 10uF; C_0805
C909, C910, C915, C921, C1204: 1uF; C_0805
C1010, C1011: 47pF; C_0603
C1401: 4.7nF; C_0805
C1502: 10nF; C_1206
D901: 1N4148WS; D_SOD-323
D1002: Yellow; LED_0603
D1401, D1402, D1403, D1404, D1405: BAV21; D_SOD-123
D1601, D1605: Red; LED_0603
D1602, D1604: Green; LED_0603
F201, F401: 15A; Fuse_CB61F
F501, F502: 3.15A; Fuse_CB61F
J201: HT_IN; Keystone_8191
J202: NEUT_IN; Keystone_8191
J203: EARTH_IN; Keystone_8191
J401: HT_OUT; Keystone_8191
J402: NEUT_OUT; Keystone_8191
J403: EARTH_OUT; Keystone_8191
J501: AUX_IN; BARREL_JACK
J801: Prog; PICKIT3_Header
J1001: USB_B_Mini; USB_Mini-B
L601: 3.3u; L_Vishay_IHLP-1212
L801, L802, L1001, L1002: 600R 0.5A; L_0603
MH1301, MH1302, MH1303, MH1305, MH1306, MH1307, MH1308: MountingHole; MountingHole_3mm
PS501: TMLM04112; ACDC-Conv_Traco-TMLM-04
Q501: DMP3099L-7; SOT-23
Q1401, Q1402, Q1403, Q1404: 2N7002; SOT-23
Q1501: BT139-600; TO-220-3_Vertical
R301, R501, R508, R602, R603, R606, R703, R704, R705, R805, R901, R902, R904, R905, R906, R909, R910, R1004, R1101, R1102, R1103, R1104, R1203, R1204, R1404, R1501, R1502, R1601, R1602, R1606, R1609: 10k; R_0603
R302, R701, R702, R806, R1201, R1202: 0; R_0603
R502, R903: 3.3k; R_0603
R605: 80.6k; R_0603
R607: 43.2k; R_0603
R608, R907: 1M; R_0603
R609: 576k; R_0603
R807, R908, R1009, R1402, R1603, R1604, R1608, R1611: 1k; R_0603
R1007, R1008: 27; R_0603
R1401: 100k; R_1206
R1403: 100k; R_0603
R1405, R1406, R1407, R1408: 10; R_0603
R1503: 220; R_0603
R1504: 1k; R_2512
R1505: 180; R_2512
R1506: 39; R_2512
SW801: MRESET; SW_PUSH_6mm
TP501, TP601, TP1001: TP; Measurement_Point_Round-SMD-Pad_Small
TP502, TP1002: TP; Pin_Header_Angled_1x01_Pitch2.54mm
U301: ACS722LLCTR-20AB; SOIC-8_3.9x4.9mm_Pitch1.27mm
U602: LT3973-DD; DFN-10-1EP_3x3mm_Pitch0.5mm
U701: PIC18LF67K40-I/PT; TQFP-64_10x10mm_Pitch0.5mm
U901, U902, U903, U904: LTC6240IS5; SOT-23-5
U1002: FT234XD; DFN-12-1EP_3x3mm_Pitch0.45mm
U1004: TPD3S014DBVR; SOT-23-6
U1101: ISO7321C; SOIC-8_3.9x4.9mm_Pitch1.27mm
U1201: SSD1306; Pin_Header_Straight_1x04_Pitch2.54mm
U1401: LTV-356T; SO-4_4.4x3.6mm_Pitch2.54mm
U1402: 74LVC1G17; SOT-353_SC-70-5
U1501: 74LVC1G32; SOT-353_SC-70-5
U1502: FOD4218; SMDIP-6_W7.62mm
X701: ASV-16.000MHz; Oscillator_SMD_Abracon_ASV-4pin_7.0x5.1mm
Z501: UDZSTE-175.1B; D_SOD-523

Connections:
+0.825V_REF: U901.3, U902.1, U902.4
+3.3VADC: C803.1, C804.1, C805.1, L801.2, U701.21
+3V3: C301.1, C302.1, C303.1, C606.1, C607.1, C608.1, C609.1, C701.1, C702.1, C703.1, C704.1, C705.1, C706.1, C708.1, C709.1, C710.1, C807.1, C901.1, C902.1, C903.1, C904.1, C905.1, C906.1, C907.1, C908.1, C909.1, C910.1, C911.1, C912.1, C913.1, C914.1, C915.1, C917.1, C918.1, C919.1, C920.1, C921.1, C1101.1, C1201.1, C1202.1, C1203.1, C1204.1, C1403.1, C1404.1, C1405.1, C1406.1, C1501.1, D1601.2, D1602.2, D1604.2, D1605.2, J801.2, L601.2, L801.1, R301.1, R602.1, R608.1, R703.1, R704.1, R705.1, R805.1, R902.1, R1101.2, R1102.2, R1203.1, R1204.1, R1601.1, TP601.1, U301.8, U602.2, U602.8, U701.10, U701.38, U901.5, U902.5, U903.5, U904.5, U1101.1, U1201.1, U1401.4, U1402.5, U1501.5, X701.4
+5V_USB: C1005.1, C1006.1, C1008.1, C1012.1, C1103.1, D1002.2, R1004.1, R1103.2, R1104.2, TP1001.1, U1002.4, U1002.9, U1004.4, U1101.8
+12V: C504.1, C505.1, C601.1, C603.1, C604.1, F502.1, Q501.2, R501.1, R605.1, TP501.1, U602.4, Z501.1
/USB UART Bridge/BRIDGE_USB+: R1007.1, U1002.12
/USB UART Bridge/BRIDGE_USB-: R1008.2, U1002.1
/USB UART Bridge/CONN_USB+: C1010.1, J1001.3, R1007.2, U1004.6
/USB UART Bridge/CONN_USB-: C1011.1, J1001.2, R1008.1, U1004.5
ADC_Error: R1408.2, R1609.1, U701.15
CLKIN: U701.39, X701.3
Comm_Error: R1406.2, R1602.1, U701.17
Earth_Protective: J203.1, J403.1
GND: C301.2, C302.2, C303.2, C504.2, C505.2, C601.2, C603.2, C604.2, C607.2, C608.2, C609.2, C701.2, C702.2, C703.2, C704.2, C705.2, C706.2, C708.2, C709.2, C710.2, C807.2, C808.2, C901.2, C902.2, C903.2, C904.2, C905.2, C906.2, C907.2, C908.2, C909.2, C910.2, C911.2, C912.2, C913.2, C914.2, C915.2, C916.2, C917.2, C918.2, C919.2, C920.2, C921.2, C1101.2, C1201.2, C1202.2, C1203.2, C1204.2, C1403.2, C1404.2, C1405.2, C1406.2, C1501.2, J501.2, J501.3, J801.3, L802.2, PS501.3, Q1401.2, Q1402.2, Q1403.2, Q1404.2, R302.1, R502.2, R508.2, R603.2, R606.2, R607.2, R609.2, R903.2, R907.2, R909.2, R1403.2, R1404.2, R1501.2, R1502.2, R1602.2, R1606.2, R1609.2, SW801.1, TP502.1, U301.5, U602.5, U602.11, U701.9, U701.41, U901.2, U902.2, U903.2, U904.2, U1101.4, U1201.2, U1402.3, U1501.3, U1502.2, X701.2
GNDA: C803.2, C804.2, C805.2, L802.1, U701.22
GNDPWR: D1402.2, D1404.2, D1405.2, R1401.2, U1401.2
GND_USB: C1004.2, C1005.2, C1006.2, C1008.2, C1009.2, C1010.2, C1011.2, C1012.2, C1013.2, C1014.2, C1103.2, J1001.5, L1002.2, TP1002.1, U1002.5, U1002.13, U1004.2, U1101.5
HT: D1401.2, D1402.1, F201.1, F501.2, U301.1, U301.2
Heartbeat: R1407.2, R1606.1, U701.16
I2C_SCL: R702.2, R1202.2
I2C_SDA: R701.1, R1201.1
ICSPCLK: J801.5, U701.42
ICSPDAT: J801.4, U701.37
ISNS_ADC: R910.2, U701.24, U904.1
ISNS_HT_OUT: Q1501.2, R1505.2, R1506.1, U301.3, U301.4
ISNS_OUT: R901.2, U301.7
NEUT: D1403.2, D1404.1, J202.1, J402.1, PS501.6
unnamed: C605.1, U602.7
unnamed: C605.2, L601.1, U602.6
unnamed: C606.2, R608.2, R609.1, U602.1
unnamed: C808.1, R806.1
unnamed: C916.1, D901.1, R906.2, R907.1, R908.1
unnamed: C1004.1, R1004.2, U1002.2
unnamed: C1009.1, U1002.3
unnamed: C1013.1, L1001.2, U1004.1, U1004.3
unnamed: C1014.1, J1001.1, L1001.1
unnamed: C1401.1, R1402.1
unnamed: C1401.2, D1401.1, D1403.1, R1401.1
unnamed: C1502.1, R1506.2
unnamed: D901.2, U903.1
unnamed: D1002.1, R1009.1
unnamed: D1405.1, R1402.2, U1401.1
unnamed: D1601.1, R1603.1
unnamed: D1602.1, R1604.1
unnamed: D1604.1, R1608.1
unnamed: D1605.1, R1611.1
unnamed: F201.2, J201.1
unnamed: F401.1, J401.1
unnamed: F501.1, PS501.5
unnamed: F502.2, PS501.2
unnamed: J501.1, Q501.3
unnamed: J1001.6, L1002.1
unnamed: Q501.1, R508.1, Z501.2
unnamed: Q1401.1, R1405.1
unnamed: Q1401.3, R1603.2
unnamed: Q1402.1, R1406.1
unnamed: Q1402.3, R1604.2
unnamed: Q1403.1, R1407.1
unnamed: Q1403.3, R1608.2
unnamed: Q1404.1, R1408.1
unnamed: Q1404.3, R1611.2
unnamed: Q1501.3, R1504.1, U1502.4
unnamed: R301.2, R302.2, U301.6
unnamed: R605.2, R606.1, U602.3
unnamed: R607.1, U602.10
unnamed: R701.2, R704.2, U701.31
unnamed: R702.1, R703.2, U701.32
unnamed: R705.2, X701.1
unnamed: R901.1, R904.1, U901.4
unnamed: R902.2, R903.1, U902.3
unnamed: R904.2, R905.1, U901.1
unnamed: R905.2, U903.3
unnamed: R906.1, U903.4
unnamed: R908.2, U904.3
unnamed: R909.1, R910.1, U904.4
unnamed: R1201.2, R1204.2, U1201.4
unnamed: R1202.1, R1203.2, U1201.3
unnamed: R1403.1, U1401.3, U1402.2
unnamed: R1503.1, U1502.1
unnamed: R1503.2, U1501.4
unnamed: R1505.1, U1502.6
POS3P3_ADC: R602.2, R603.1, U701.64
POS12_ADC: R501.2, R502.1, U701.28
SSR_Dim: R1501.1, U701.4, U1501.1
SSR_Force: R1502.1, U701.3, U1501.2
TRIAC_HT_OUT: C1502.2, F401.2, Q1501.1, R1504.2
USB_UART_RX: R1101.1, U701.20, U1101.2
USB_UART_RX_ISO: R1104.1, U1002.7, U1101.7
USB_UART_TX: R1102.1, U701.19, U1101.3
USB_UART_TX_ISO: R1103.1, U1002.10, U1101.6
Zero_Cross_Detect: R1404.1, U701.27, U1402.4
~Active: R1405.2, R1601.2, U701.18
~MCLR: J801.1, R807.1, U701.7
~MRST: R805.2, R806.2, R807.2, SW801.2
~USB_ACTIVE: R1009.2, U1002.6
