drewsum/AC_Power_Meter/sfw/U701_Firmware/AC_Power_Meter.X/ring_buffer_LUT.h

/* 
 * File:   ring_buffer_LUT.h
 * Author: Drew Maatman
 *
 * Created on January 17, 2018, 8:00 PM
 */

#include "mcc_generated_files/mcc.h"
#include <string.h>
#include <stdlib.h>
#include <stdio.h>
#include <xc.h>

#include "ring_buffer_interface.h"

#ifndef RING_BUFFER_LUT_H
#define	RING_BUFFER_LUT_H

#ifdef	__cplusplus
extern "C" {
#endif
   
    
/*
  @Summary
    This routine compares the string passed to it and acts on it if it matches
    any of the strings entered. This is how commands should be programmed.

  @Description
    

  @Preconditions
    Having an MCC generated UART driver, and adding the stuff listed below
    Some variables in this file should be edited to use correct EUSART module
    if there are multiple modules within the microcontroller being used

  @Param
    Pointer to a string to be checked and acted on

  @Returns
    None

  @Comment
    

  @Example

*/
void ringBufferLUT(char * line);


// This function dumps a bunch of debug data on reset to the serial port
void terminal_printResetMessage(void);



#ifdef	__cplusplus
}
#endif

#endif	/* RING_BUFFER_LUT_H */
