drewsum/AC_Power_Meter/(commit log)

2018-10-01 Added KiCad project with a few sheets filled out
    [AC_Current_Sensor.sch, AC_Input.sch, AC_Output.sch, AC_Power_Meter.kicad_pcb, AC_Power_Meter.sch, Mechanical.sch, Microcontroller.sch, Microcontroller_Programming.sch]
2018-10-01 Populated USB circuit pages
    [USB_UART_Bridge.sch, USB_UART_Isolation.sch]
2018-10-02 Added zero cross detect circuit
    [AC_Current_Sensor.sch, AC_Input.sch, AC_Output.sch, AC_Power_Meter.sch, Mechanical.sch, Microcontroller.sch, Microcontroller_Programming.sch, OLED_Display.sch]
2018-10-02 Added TRIAC circuit and POS12 AC/DC converter
    [AC_Current_Sensor.sch, Output_Switch.sch, POS12_Power_Supply.sch, Zero_Cross_Detect.sch]
2018-10-02 Added AC input and output connections, added mechanical components
    [AC_Input.sch, AC_Output.sch, Mechanical.sch, POS12_Power_Supply.sch]
2018-10-02 Added supporting parts for OLED display
    [OLED_Display.sch]
2018-10-03 Added +3.3V power supply, +12V window comparator, a few design files
    [AC_Current_Sensor.sch, AC_Input.sch, AC_Output.sch, AC_Power_Meter.sch, Mechanical.sch, Microcontroller.sch, Microcontroller_Programming.sch, OLED_Display.sch]
2018-10-03 Added MU logo and titles to all sheets
    [AC_Current_Sensor.sch, AC_Input.sch, AC_Output.sch, AC_Power_Meter.sch, Mechanical.sch, Microcontroller.sch, Microcontroller_Programming.sch, OLED_Display.sch]
2018-10-03 Updated MU logo to crisper image
    [AC_Current_Sensor.sch, AC_Input.sch, AC_Output.sch, AC_Power_Meter.sch, Mechanical.sch, Microcontroller.sch, Microcontroller_Programming.sch, OLED_Display.sch]
2018-10-04 Added ORing circuit to TRIAC page
    [Output_Switch.sch, USB_UART_Bridge.sch, USB_UART_Isolation.sch]
2018-10-04 Added series resistor in ZCD circuit
    [Output_Switch.sch, USB_UART_Isolation.sch, Zero_Cross_Detect.sch]
2018-10-05 Revised signal conditioning, cleaned up a lot of pages
    [AC_Current_Sensor.sch, AC_Input.sch, AC_Output.sch, Microcontroller.sch, Microcontroller_Programming.sch, POS12_Power_Supply.sch, Sensor_Signal_Conditioning.sch]
2018-10-05 Added pushbuttons sheet, prelim wiring on micro
    [AC_Current_Sensor.sch, AC_Input.sch, AC_Output.sch, AC_Power_Meter.sch, Mechanical.sch, Microcontroller.sch, Microcontroller_Programming.sch, OLED_Display.sch]
2018-10-05 Rewired a few micro symbols, add FMW notes
    [AC_Current_Sensor.sch, AC_Input.sch, AC_Output.sch, AC_Power_Meter.sch, Firmware_Notes.sch, Mechanical.sch, Microcontroller.sch, Microcontroller_Programming.sch]
2018-10-05 Updated most footprints
    [AC_Current_Sensor.sch, AC_Input.sch, AC_Output.sch, AC_Power_Meter.sch, Mechanical.sch, Microcontroller.sch, Microcontroller_Programming.sch, OLED_Display.sch]
2018-10-06 Finished assigning footprints, added netlist
    [AC_Input.sch, AC_Output.sch]
2018-10-06 Pulled parts into PCB
    [AC_Power_Meter.kicad_pcb]
2018-10-06 Arranged a few pages of components
    [AC_Power_Meter.kicad_pcb, Microcontroller.sch, Output_Switch.sch, Pushbuttons.sch, Sensor_Signal_Conditioning.sch, USB_UART_Bridge.sch, USB_UART_Isolation.sch, Zero_Cross_Detect.sch]
2018-10-07 Nailed down board outline, placed a few sections
    [AC_Power_Meter.kicad_pcb, Mechanical.sch, POS12_Power_Supply.sch, Pushbuttons.sch, Sensor_Signal_Conditioning.sch]
2018-10-07 Placed a lot more parts, netlist cleanup
    [AC_Current_Sensor.sch, AC_Power_Meter.kicad_pcb, Pushbuttons.sch]
2018-10-07 Finished placing parts
    [AC_Power_Meter.kicad_pcb, Firmware_Notes.sch, Microcontroller.sch]
2018-10-07 Made a fw minor adjustments to PCB
    [AC_Input.sch, AC_Power_Meter.kicad_pcb, Mechanical.sch]
2018-10-07 Added some PCB design rules
    [AC_Power_Meter.kicad_pcb]
2018-10-07 Finished assigning design rules to nets
    [AC_Power_Meter.kicad_pcb]
2018-10-07 Routed much more of the board, design rule fixes
    [AC_Power_Meter.kicad_pcb, USB_UART_Bridge.sch, USB_UART_Isolation.sch]
2018-10-08 MOAR ROUTING
    [AC_Current_Sensor.sch, AC_Power_Meter.kicad_pcb]
2018-10-08 Finished routing, adding bells and whistles
    [AC_Power_Meter.kicad_pcb, Firmware_Notes.sch, Microcontroller.sch, Output_Switch.sch, POS12_Power_Supply.sch]
2018-10-08 Added a few more finishing touches, moved some components
    [AC_Power_Meter.kicad_pcb]
2018-10-09 A few routing adjustments and more graphics added to PCB
    [AC_Power_Meter.kicad_pcb, Microcontroller_Programming.sch, Pushbuttons.sch]
2018-10-09 Serious BOM scrubbing to drive price down
    [AC_Current_Sensor.sch, AC_Input.sch, AC_Output.sch, AC_Power_Meter.kicad_pcb, AC_Power_Meter.sch, AC_Power_Meter_bom.xlsx, Firmware_Notes.sch, Mechanical.sch]
2018-10-10 Finished up PCB
    [AC_Power_Meter.kicad_pcb, AC_Power_Meter.sch]
2018-10-27 Modified schematic and board files slightly
    [AC_Current_Sensor.sch, AC_Power_Meter.kicad_pcb, AC_Power_Meter_bom.xlsx]
2018-10-27 Started writing PIC firmware
    [AC_Power_Meter.X.production.obj]
2018-10-28 Added ADC and timer functionality to measure supply rails and print to terminal
    [AC_Power_Meter.X.production.obj]
2018-10-28 Added more cool functionality
    [AC_Power_Meter.X.production.obj]
2018-11-01 Added a lot of functionality in formware
    [AC_Current_Sensor.sch, AC_Power_Meter.X.production.obj, Sensor_Signal_Conditioning.sch, USB_UART_Bridge.sch]
2018-11-02 Cleaned up set dimming percentage command
    [AC_Power_Meter.X.production.obj]
2018-11-02 Added functionality to set rms values to 0.0 when SSR is off
    [AC_Power_Meter.X.production.obj]
2018-11-02 Cleaned up help message
    [AC_Power_Meter.X.production.obj]
2018-11-02 Cleaned up some variables, added load on time measurement
    [AC_Power_Meter.X.production.obj]
2018-11-03 Added serial support for printing device ID
    [AC_Power_Meter.X.production.obj]
2018-11-04 Added ADC error detection and relevant serial commands
    [AC_Power_Meter.X.production.obj]
2018-11-04 Added VCC overvoltage detection and related serial commands
    [AC_Power_Meter.X.production.obj]
2018-11-05 Heavily revised cause of reset functionality
    [AC_Power_Meter.X.production.obj]
2018-11-05 Fixed issues with VCC overvoltage detection
    [AC_Power_Meter.X.production.obj]
2018-11-06 Removed overkill newlines in serial interface replies
    [AC_Power_Meter.X.production.obj]
2018-11-06 Further cleaned up serial LUT code
    [AC_Power_Meter.X.production.obj]
2018-11-06 Got ADC digital filtering working
    [AC_Power_Meter.X.production.obj]
2018-11-06 Added output state check commands
    [AC_Power_Meter.X.production.obj]
2018-11-06 Cleaned up more serial commands
    [AC_Power_Meter.X.production.obj]
2018-11-06 Added functionality to save and retrieve maximum RMS current and power
    [AC_Power_Meter.X.production.obj]
2018-11-06 Added clear max values command
    [AC_Power_Meter.X.production.obj]
2018-11-07 Added more maximum value functionality
    [AC_Power_Meter.X.production.obj]
2018-11-07 cleaned up erase max values functionality, help serial commands
    [AC_Power_Meter.X.production.obj]
2018-11-07 Updated README to include software versions
    [AC_Current_Sensor.sch, AC_Input.sch, AC_Output.sch, AC_Power_Meter.kicad_pcb, AC_Power_Meter.sch, Firmware_Notes.sch, Mechanical.sch, Microcontroller.sch]
2018-11-08 Added dimming functionality
    [AC_Power_Meter.X.production.obj]
2018-11-08 Added HLVD detect functionality to save total energy to EEPROM at power fail
    [AC_Power_Meter.X.production.obj]
2018-11-08 Added energy EEPROM periodic write interupt routines
    [AC_Power_Meter.X.production.obj]
2018-11-09 broken ADC
    [AC_Power_Meter.X.production.obj]
2018-11-09 ADC and Temp Sensor bug fixes
    [AC_Power_Meter.X.production.obj]
2018-11-13 Added baseline OLED I2C driver
    [AC_Power_Meter.X.production.obj]
2018-11-13 Added expanded error handling
    [AC_Power_Meter.X.production.obj]
2018-11-13 Added more elegant OLED ram buffer update method
    [AC_Power_Meter.X.production.obj]
2018-11-13 Resolved some comm error detection issues
    [AC_Power_Meter.X.production.obj]
2018-11-13 Added a lot of OLED support
    [AC_Power_Meter.X.production.obj]
2018-11-16 Fixed bug with upper case S in OLED font array
    [AC_Power_Meter.X.production.obj]
2018-11-17 Fixed bug where pickit3 would write over saved EEPROM variables, other bug fixes
    [AC_Power_Meter.X.production.obj]
2018-11-17 fixed uart comm error LED bug
    [AC_Power_Meter.X.production.obj]
2018-11-17 More OLED bug fixes, variable frame periods
    [AC_Power_Meter.X.production.obj]
2018-11-18 Added awesome terminal boot message
    [AC_Power_Meter.X.production.obj]
2018-11-18 Added unsupported command response
    [AC_Power_Meter.X.production.obj]
2018-11-18 Bug fixes
    [AC_Power_Meter.X.production.obj]
2018-11-18 Added device and measurement summary serial commands
    [AC_Power_Meter.X.production.obj]
2018-11-18 Added live update test code
    [AC_Power_Meter.X.production.obj]
2018-11-19 Schematic cleanup, live updates working in code
    [AC_Current_Sensor.sch, AC_Power_Meter.X.production.obj, Microcontroller.sch, Microcontroller_Programming.sch, OLED_Display.sch, Output_Switch.sch, POS3P3_Power_Supply.sch, Sensor_Signal_Conditioning.sch]
2018-11-19 Current sense ADC bug fixes
    [AC_Power_Meter.X.production.obj]
2018-12-04 Fixed ISNS DC offset issue
    [AC_Power_Meter.X.production.obj, AC_Power_Meter_bom.xlsx]
